RealManRobot/rm_models/RML63/dimension/RML63III_Full_Arm_Dimension_Specification.pdf

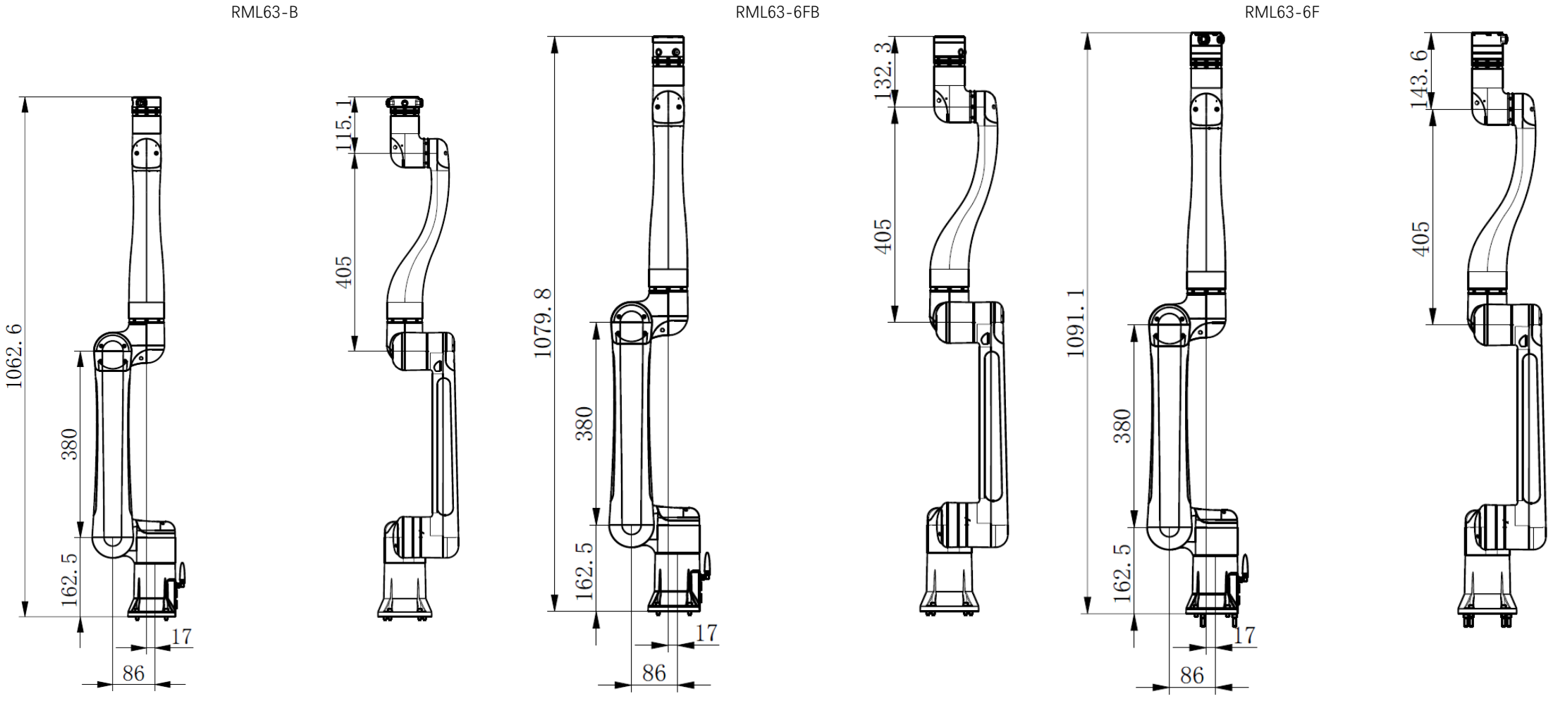
[picture p1: page 1]

RML63-B | RML63-6FB | RML63-6F
