RealManRobot/rm_models/ECO62/urdf/ECO62-B/meshes/link_1.STL

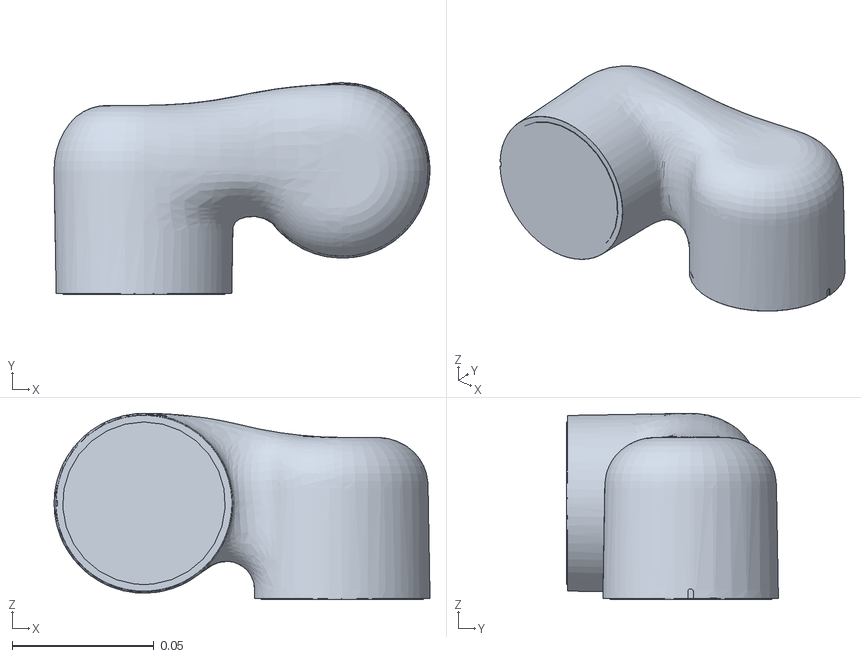
[picture p2: CAD file, 2026-03-18]
ECO62/urdf/ECO62-B/meshes/link_1.STL
0.133 x 0.0748 x 0.0658
