RealManRobot/rm_models/RM65/urdf/RM65-6FB-V/meshes/camera_link.STL

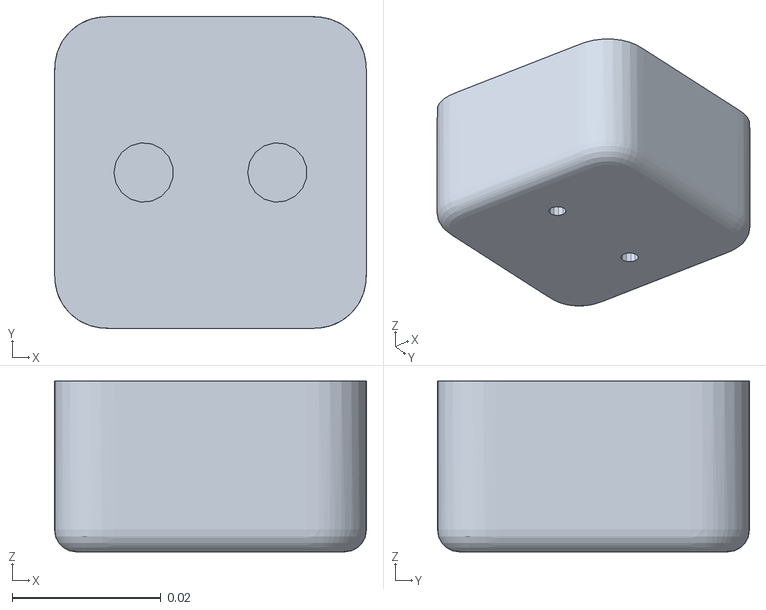
[picture p3: CAD file, 2025-12-05]
RM65/urdf/RM65-6FB-V/meshes/camera_link.STL
0.042 x 0.042 x 0.023
