RealManRobot/rm_models/RM65/urdf/RM65-B-V/meshes/camera_rolink.STL

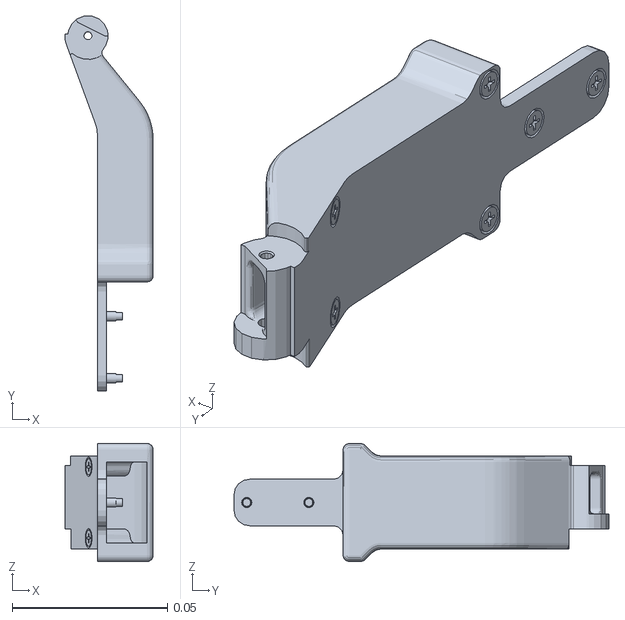
[picture p4: CAD file, 2025-12-05]
RM65/urdf/RM65-B-V/meshes/camera_rolink.STL
0.0285 x 0.121 x 0.038
