RealManRobot/rm_models/RX75/urdf/RX75-B-V/RXL-B-V/meshes/base_link.STL

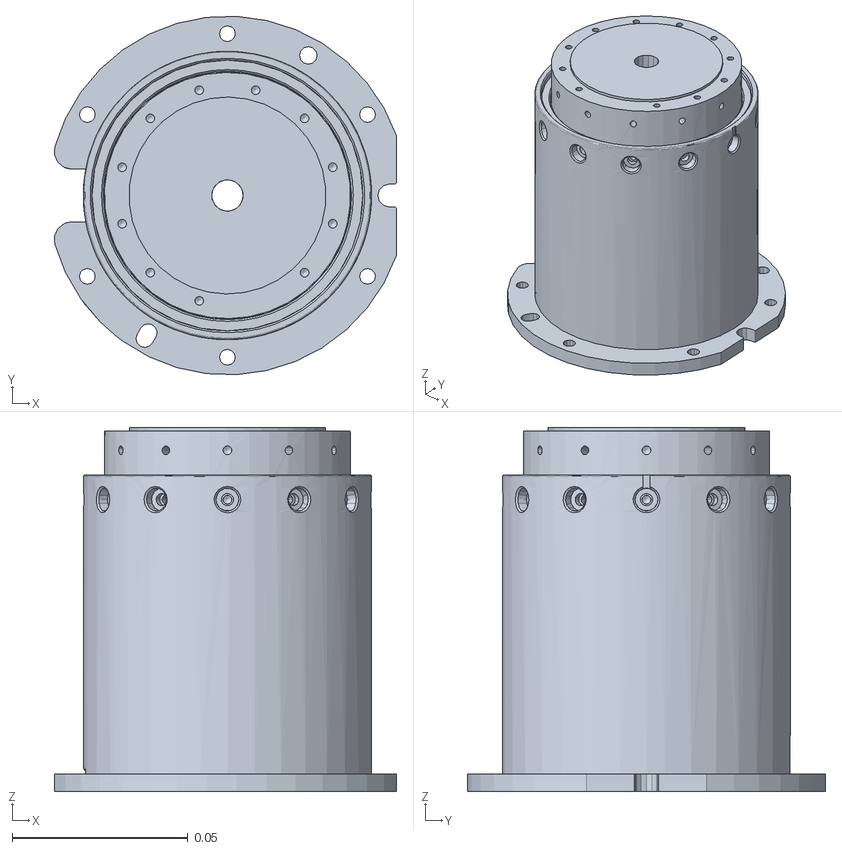
[picture p5: CAD file, 2026-07-03]
RX75/urdf/RX75-B-V/RXL-B-V/meshes/base_link.STL
0.0973 x 0.102 x 0.104
