RealManRobot/rm_models/RX75/urdf/RX75-B-V/RXR-B-V/meshes/Link2.STL

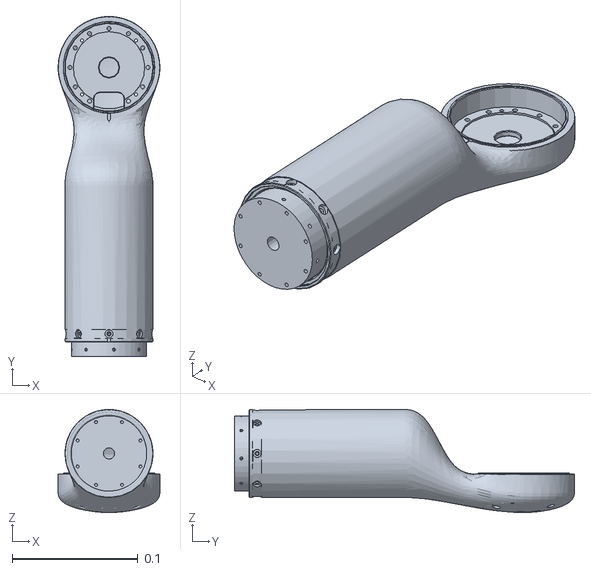
[picture p6: CAD file, 2026-07-03]
RX75/urdf/RX75-B-V/RXR-B-V/meshes/Link2.STL
0.081 x 0.271 x 0.082
