RealManRobot/rm_models/ECO62/urdf/ECO62-B/meshes/link_5.STL

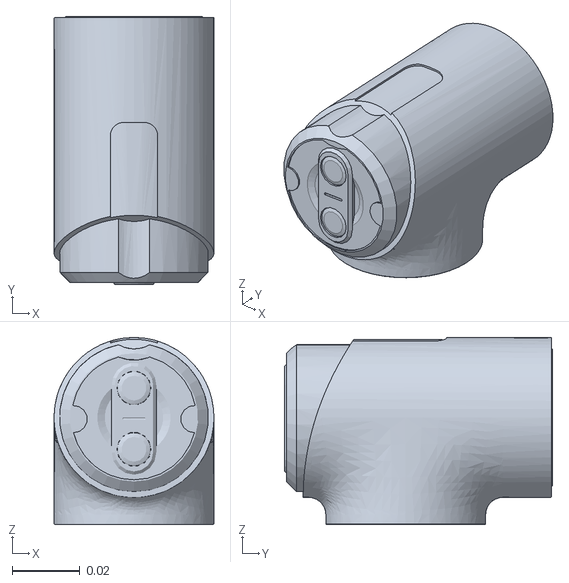
[picture p7: CAD file, 2026-03-18]
ECO62/urdf/ECO62-B/meshes/link_5.STL
0.047 x 0.0789 x 0.055
