RealManRobot/rm_models/GEN72/urdf/gen_72_b_description/meshes/base_link.STL

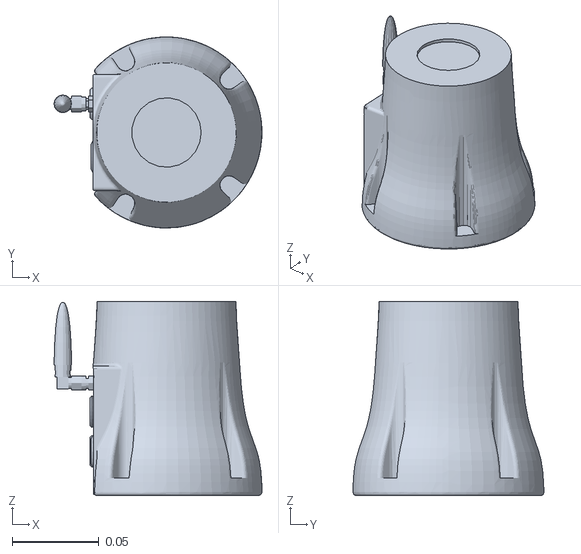
[picture p8: CAD file, 2024-08-14]
GEN72/urdf/gen_72_b_description/meshes/base_link.STL
0.12 x 0.11 x 0.112
