RealManRobot/rm_models/RM75/urdf/RM75-6F/meshes/link_7.STL

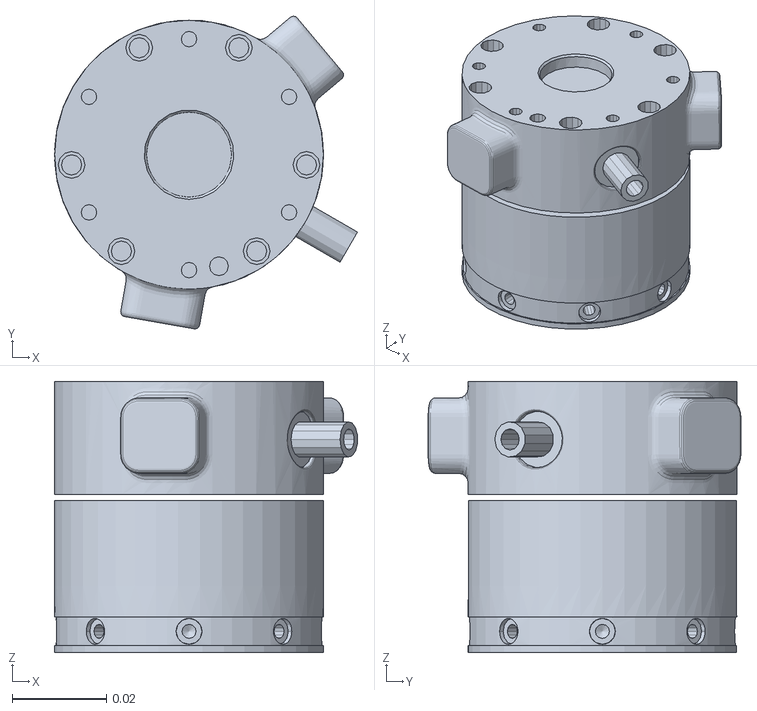
[picture p9: CAD file, 2025-12-05]
RM75/urdf/RM75-6F/meshes/link_7.STL
0.0643 x 0.0663 x 0.0575
