RealManRobot/rm_models/RX75/urdf/RX75-B-V/RXL-B-V/meshes/Link6.STL

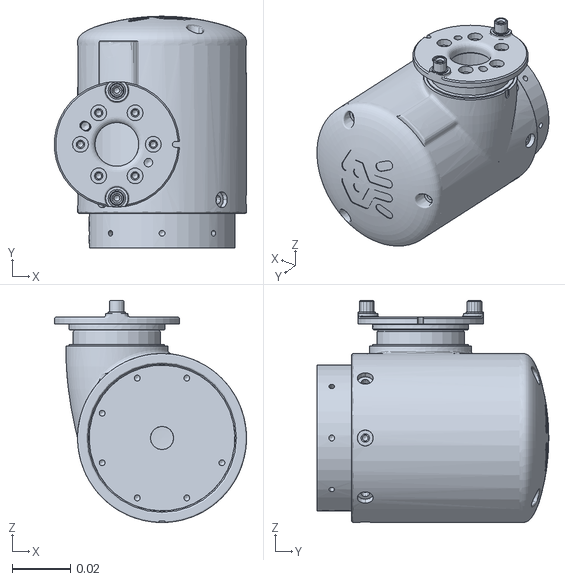
[picture p10: CAD file, 2026-07-03]
RX75/urdf/RX75-B-V/RXL-B-V/meshes/Link6.STL
0.0659 x 0.0795 x 0.0762
