RealManRobot/rm_models/RX75/urdf/RX75-B-V/RXR-B-V/meshes/Link8.STL

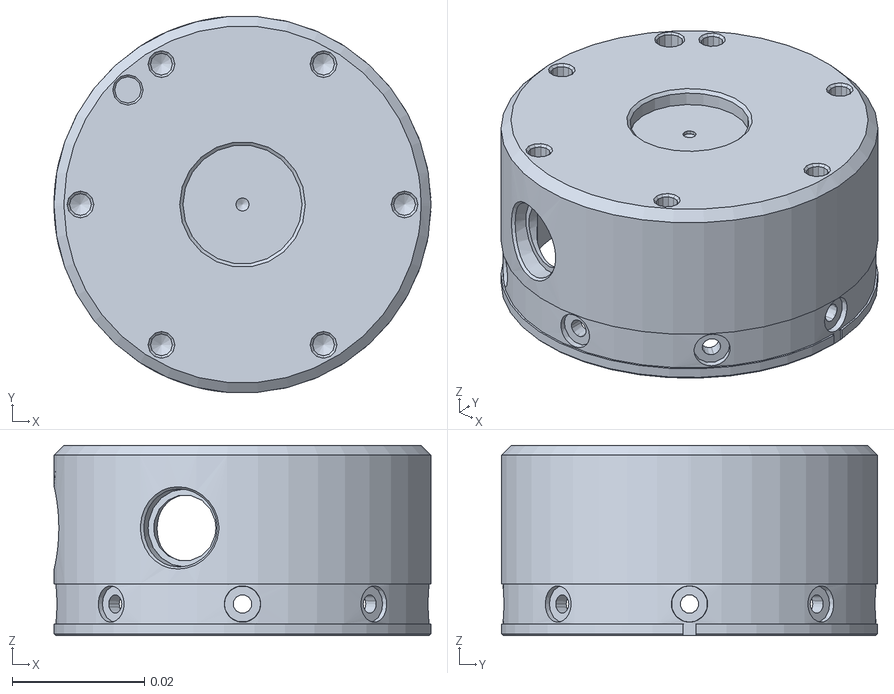
[picture p11: CAD file, 2026-07-03]
RX75/urdf/RX75-B-V/RXR-B-V/meshes/Link8.STL
0.057 x 0.0569 x 0.0288
