RealManRobot/rm_models/ECO62/urdf/ECO62-B/meshes/link_6.STL

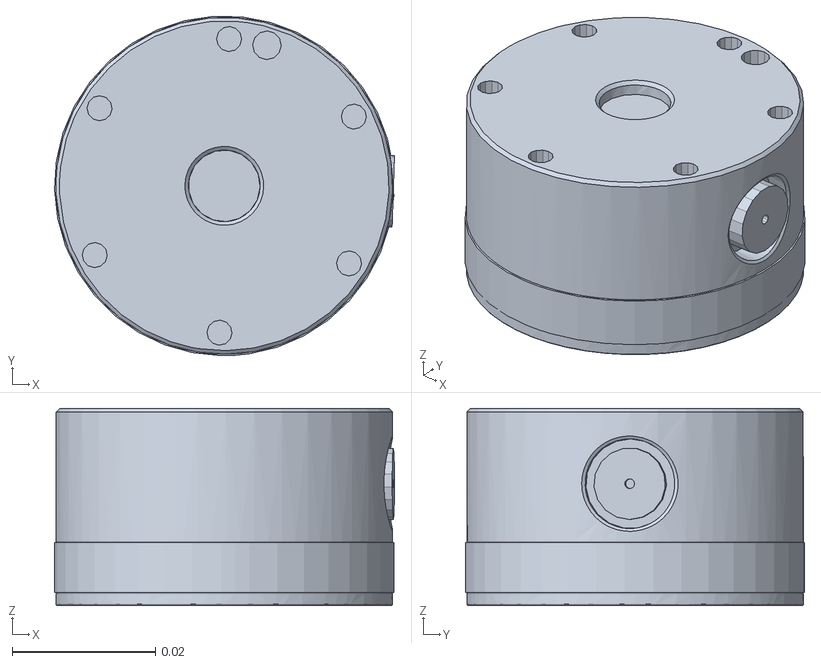
[picture p12: CAD file, 2026-03-18]
ECO62/urdf/ECO62-B/meshes/link_6.STL
0.0474 x 0.0473 x 0.0275
