RealManRobot/rm_models/RM75/urdf/RM75-6FB-V/meshes/link_7.STL

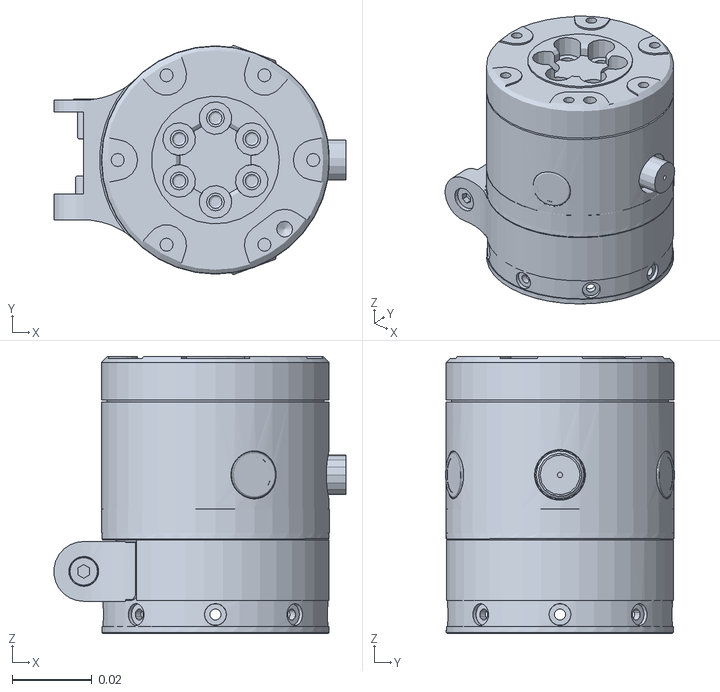
[picture p13: CAD file, 2025-12-05]
RM75/urdf/RM75-6FB-V/meshes/link_7.STL
0.0731 x 0.0574 x 0.0695
