RealManRobot/rm_models/RM75/urdf/RM75-B-V/meshes/link_7.STL

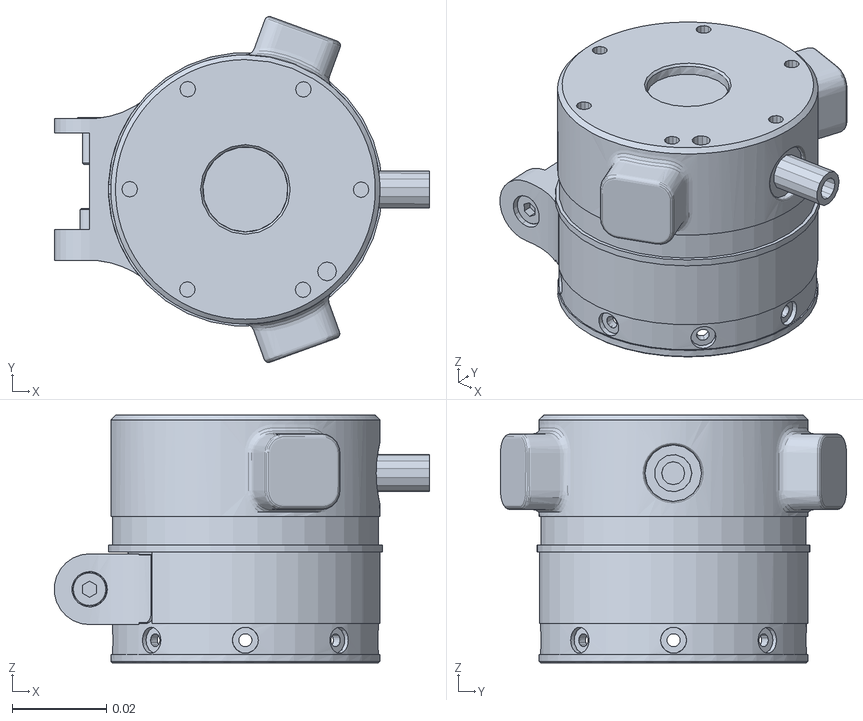
[picture p14: CAD file, 2025-12-05]
RM75/urdf/RM75-B-V/meshes/link_7.STL
0.0795 x 0.0733 x 0.0525
