RealManRobot/rm_models/RML63/urdf/RML63II/RML63II-6FB-V/meshes/camera_link.STL

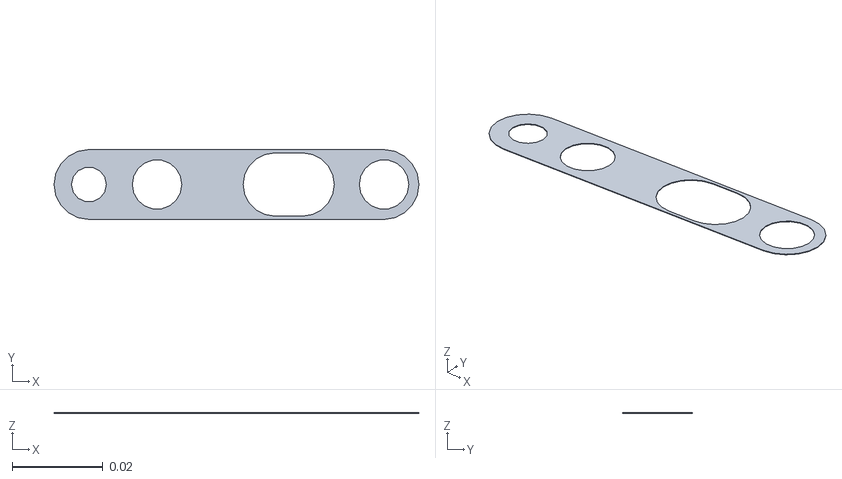
[picture p15: CAD file, 2025-12-05]
RML63/urdf/RML63II/RML63II-6FB-V/meshes/camera_link.STL
0.0804 x 0.0154 x 0.00013
