RealManRobot/rm_models/RX75/urdf/RX75-B-V/RXR-B-V/meshes/Link4.STL

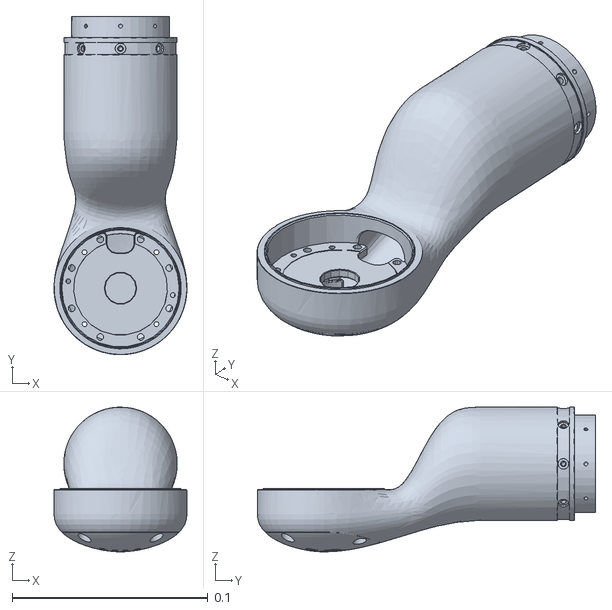
[picture p16: CAD file, 2026-07-03]
RX75/urdf/RX75-B-V/RXR-B-V/meshes/Link4.STL
0.068 x 0.173 x 0.074
