RealManRobot/rm_models/ECO62/urdf/ECO62-B/meshes/base_link.STL

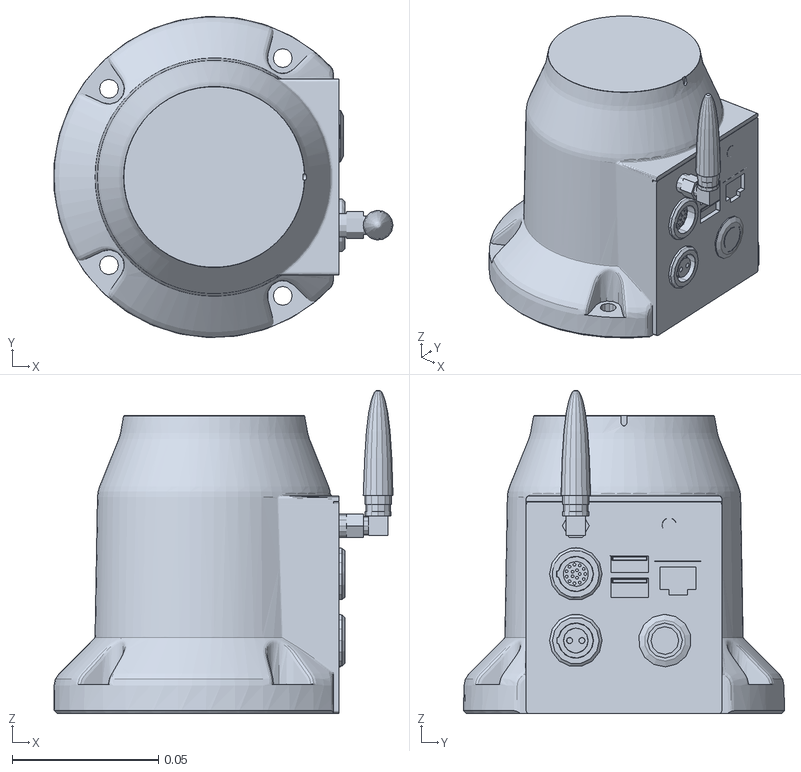
[picture p17: CAD file, 2026-03-18]
ECO62/urdf/ECO62-B/meshes/base_link.STL
0.116 x 0.11 x 0.111
