RealManRobot/rm_models/RX75/urdf/RX75-B-V/RXR-B-V/meshes/Link5.STL

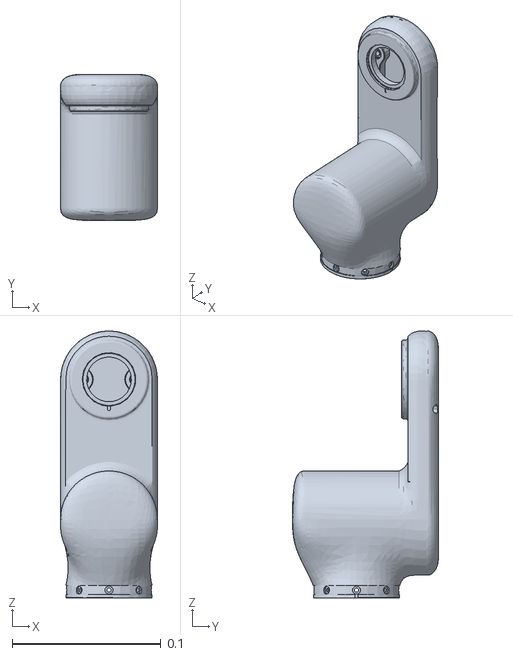
[picture p18: CAD file, 2026-07-03]
RX75/urdf/RX75-B-V/RXR-B-V/meshes/Link5.STL
0.065 x 0.0981 x 0.179
