RealManRobot/rm_models/ECO62/urdf/ECO62-B/meshes/link_3.STL

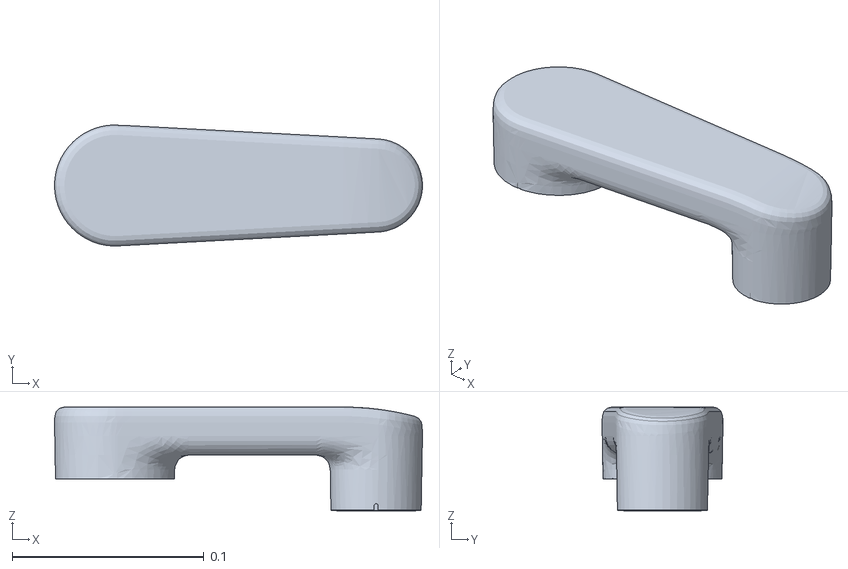
[picture p19: CAD file, 2026-03-18]
ECO62/urdf/ECO62-B/meshes/link_3.STL
0.192 x 0.063 x 0.0541
