RealManRobot/rm_models/RX75/urdf/RX75-B-V/RXR-B-V/meshes/Link3.STL

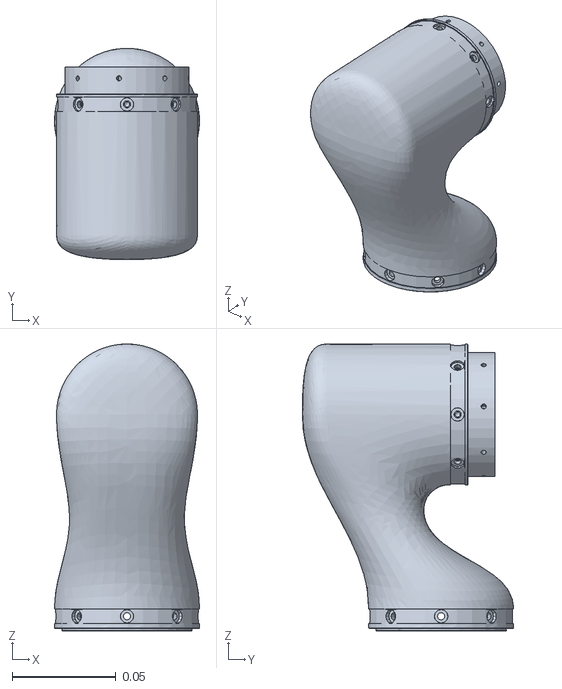
[picture p20: CAD file, 2026-03-25]
RX75/urdf/RX75-B-V/RXR-B-V/meshes/Link3.STL
0.07 x 0.102 x 0.138
