RealManRobot/rm_models/ECO62/urdf/ECO62-B/meshes/link_4.STL

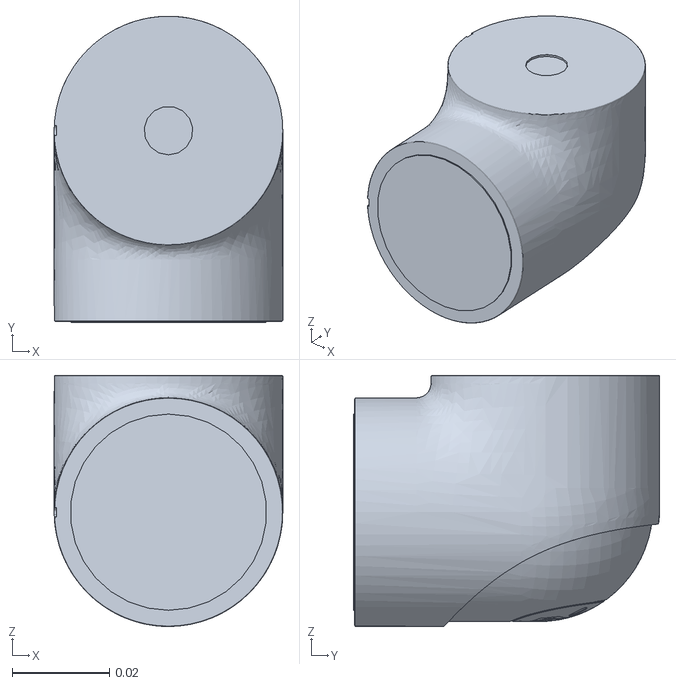
[picture p21: CAD file, 2026-03-18]
ECO62/urdf/ECO62-B/meshes/link_4.STL
0.047 x 0.063 x 0.0516
