RealManRobot/rm_models/RX75/urdf/RX75-B-V/RXL-B-V/meshes/Link7.STL

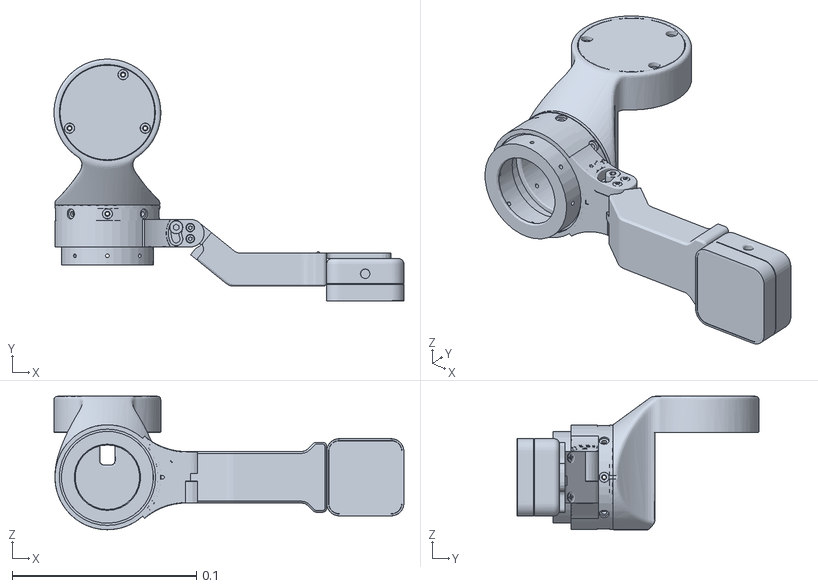
[picture p22: CAD file, 2026-07-03]
RX75/urdf/RX75-B-V/RXL-B-V/meshes/Link7.STL
0.19 x 0.131 x 0.0725
