RealManRobot/rm_models/RX75/urdf/RX75-B-V/RXR-B-V/meshes/Link7.STL

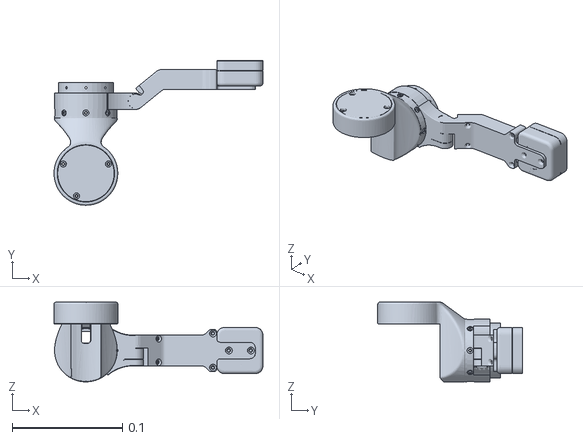
[picture p23: CAD file, 2026-03-25]
RX75/urdf/RX75-B-V/RXR-B-V/meshes/Link7.STL
0.19 x 0.131 x 0.0725
