RealManRobot/rm_models/ECO62/urdf/ECO62-B/meshes/link_2.STL

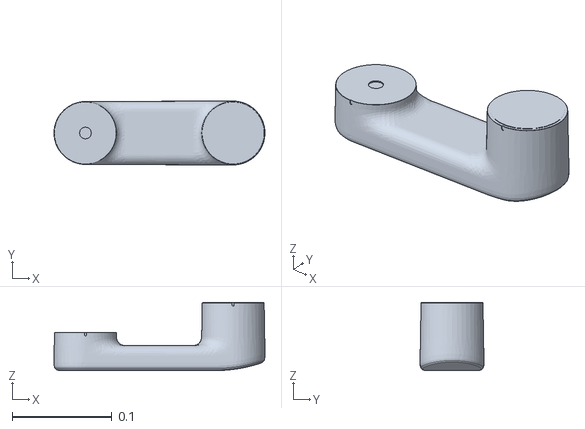
[picture p24: CAD file, 2026-03-18]
ECO62/urdf/ECO62-B/meshes/link_2.STL
0.211 x 0.064 x 0.0683
