RealManRobot/rm_models/RM75/urdf/RM75-6FB/meshes/link_7.STL

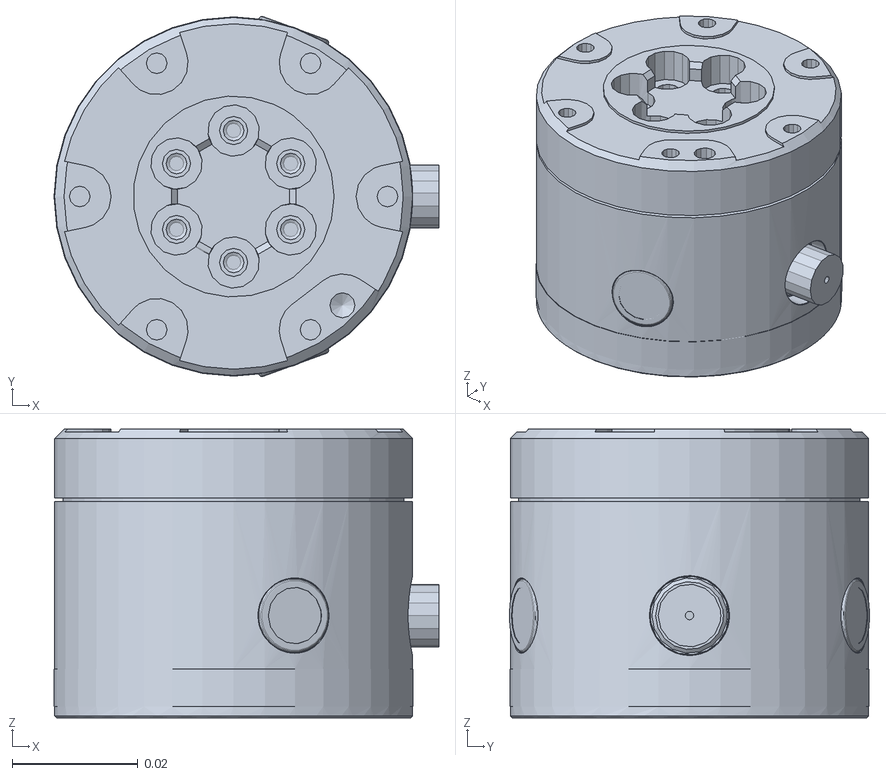
[picture p25: CAD file, 2025-12-05]
RM75/urdf/RM75-6FB/meshes/link_7.STL
0.0613 x 0.0574 x 0.046
