RealManRobot/rm_models/RX75/urdf/RX75-B-V/RXL-B-V/meshes/Link1.STL

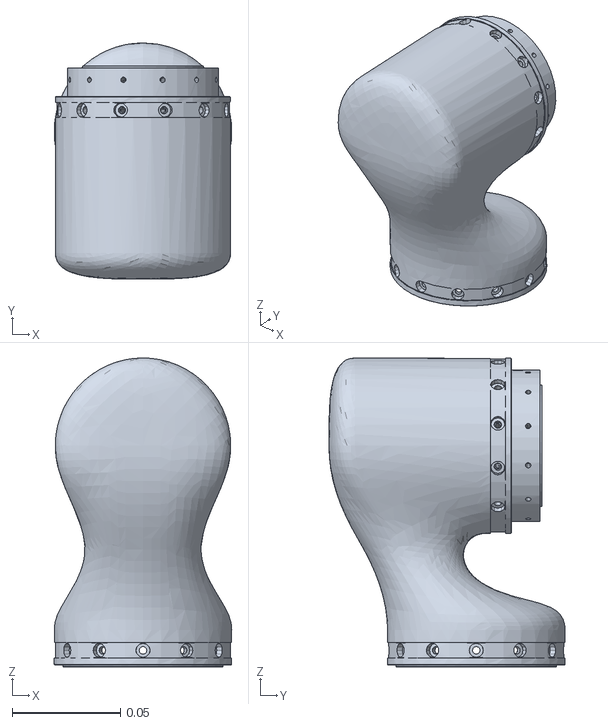
[picture p27: CAD file, 2026-03-25]
RX75/urdf/RX75-B-V/RXL-B-V/meshes/Link1.STL
0.082 x 0.109 x 0.143
