RealManRobot/rm_models/(list of files, cad)

Other CAD files:
RML63/urdf/RML63III/RML63III-6FB-V/meshes/camera_rolink.STL
RML63/urdf/RML63III/RML63III-B-V/meshes/camera_link.STL
RML63/urdf/RML63III/RML63III-6FB-V/meshes/camera_link.STL
RX75/urdf/RX75-B-V/RXL-B-V/meshes/Link2.STL
RX75/urdf/RX75-B-V/RXL-B-V/meshes/Link8.STL
RX75/urdf/RX75-6FB-V/RXL-6FB-V/meshes/base_link.STL
RX75/urdf/RX75-6FB/RXL-6F-C3/meshes/Link2L.STL
RX75/urdf/RX75-B-V/RXL-B-V/meshes/Link5.STL
RX75/urdf/RX75-6FB/RXL-6F-C3/meshes/base_link.STL
RX75/urdf/RX75-B-V/RXL-B-V/meshes/Link4.STL
RX75/urdf/RX75-B-V/RXR-B-V/meshes/Link6.STL
RML63/urdf/RML63III/RML63III-B-V/meshes/camera_rolink.STL
RX75/urdf/RX75-B-V/RXR-B-V/meshes/Link1.STL
RX75/urdf/RX75-B-V/RXL-B-V/meshes/Link3.STL
RX75/urdf/RX75-B-V/RXR-B-V/meshes/base_link.STL
ECO63/urdf/ECO63-6F/meshes/base_link.STL
ECO63/urdf/ECO63-6F/meshes/link_1.STL
ECO63/urdf/ECO63-6F/meshes/link_2.STL
ECO63/urdf/ECO63-6F/meshes/link_3.STL
ECO63/urdf/ECO63-6F/meshes/link_4.STL
ECO63/urdf/ECO63-6F/meshes/link_5.STL
ECO63/urdf/ECO63-6F/meshes/link_6.STL
ECO63/urdf/ECO63-6FB/meshes/base_link.STL
ECO63/urdf/ECO63-6FB/meshes/link_1.STL
ECO63/urdf/ECO63-6FB/meshes/link_2.STL
ECO63/urdf/ECO63-6FB/meshes/link_3.STL
ECO63/urdf/ECO63-6FB/meshes/link_4.STL
ECO63/urdf/ECO63-6FB/meshes/link_5.STL
ECO63/urdf/ECO63-6FB/meshes/link_6.STL
ECO63/urdf/ECO63-B/meshes/base_link.STL
ECO63/urdf/ECO63-B/meshes/link_1.STL
ECO63/urdf/ECO63-B/meshes/link_2.STL
ECO63/urdf/ECO63-B/meshes/link_3.STL
ECO63/urdf/ECO63-B/meshes/link_4.STL
ECO63/urdf/ECO63-B/meshes/link_5.STL
ECO63/urdf/ECO63-B/meshes/link_6.STL
ECO65/urdf/ECO65-6F/meshes/base_link.STL
ECO65/urdf/ECO65-6F/meshes/link_1.STL
ECO65/urdf/ECO65-6F/meshes/link_2.STL
ECO65/urdf/ECO65-6F/meshes/link_3.STL
ECO65/urdf/ECO65-6F/meshes/link_4.STL
ECO65/urdf/ECO65-6F/meshes/link_5.STL
ECO65/urdf/ECO65-6F/meshes/link_6.STL
ECO65/urdf/ECO65-6FB/meshes/base_link.STL
ECO65/urdf/ECO65-6FB/meshes/link_1.STL
ECO65/urdf/ECO65-6FB/meshes/link_2.STL
ECO65/urdf/ECO65-6FB/meshes/link_3.STL
ECO65/urdf/ECO65-6FB/meshes/link_4.STL
ECO65/urdf/ECO65-6FB/meshes/link_5.STL
ECO65/urdf/ECO65-6FB/meshes/link_6.STL
ECO65/urdf/ECO65-B/meshes/base_link.STL
ECO65/urdf/ECO65-B/meshes/link_1.STL
ECO65/urdf/ECO65-B/meshes/link_2.STL
ECO65/urdf/ECO65-B/meshes/link_3.STL
ECO65/urdf/ECO65-B/meshes/link_4.STL
ECO65/urdf/ECO65-B/meshes/link_5.STL
ECO65/urdf/ECO65-B/meshes/link_6.STL
GEN72/urdf/gen_72_b_description/meshes/Link1.STL
GEN72/urdf/gen_72_b_description/meshes/Link2.STL
GEN72/urdf/gen_72_b_description/meshes/Link3.STL
GEN72/urdf/gen_72_b_description/meshes/Link4.STL
GEN72/urdf/gen_72_b_description/meshes/Link5.STL
GEN72/urdf/gen_72_b_description/meshes/Link6.STL
GEN72/urdf/gen_72_b_description/meshes/Link7.STL
RM65/urdf/RM65-6F/meshes/base_link.STL
RM65/urdf/RM65-6F/meshes/link_1.STL
RM65/urdf/RM65-6F/meshes/link_2.STL
RM65/urdf/RM65-6F/meshes/link_3.STL
RM65/urdf/RM65-6F/meshes/link_4.STL
RM65/urdf/RM65-6F/meshes/link_5.STL
RM65/urdf/RM65-6FB-V/meshes/base_link.STL
RM65/urdf/RM65-6FB-V/meshes/link_1.STL
RM65/urdf/RM65-6FB-V/meshes/link_2.STL
RM65/urdf/RM65-6FB-V/meshes/link_3.STL
RM65/urdf/RM65-6FB-V/meshes/link_4.STL
RM65/urdf/RM65-6FB-V/meshes/link_5.STL
RM65/urdf/RM65-6FB-V/meshes/link_6.STL
RM65/urdf/RM65-6FB/meshes/base_link.STL
RM65/urdf/RM65-6FB/meshes/link_1.STL
RM65/urdf/RM65-6FB/meshes/link_2.STL
RM65/urdf/RM65-6FB/meshes/link_3.STL
RM65/urdf/RM65-6FB/meshes/link_4.STL
RM65/urdf/RM65-6FB/meshes/link_5.STL
RM65/urdf/RM65-6FB/meshes/link_6.STL
RM65/urdf/RM65-B-V/meshes/base_link.STL
RM65/urdf/RM65-B-V/meshes/link_1.STL
RM65/urdf/RM65-B-V/meshes/link_2.STL
RM65/urdf/RM65-B-V/meshes/link_3.STL
RM65/urdf/RM65-B-V/meshes/link_4.STL
RM65/urdf/RM65-B-V/meshes/link_5.STL
RM65/urdf/RM65-B/meshes/base_link.STL
RM65/urdf/RM65-B/meshes/link_1.STL
RM65/urdf/RM65-B/meshes/link_2.STL
RM65/urdf/RM65-B/meshes/link_3.STL
RM65/urdf/RM65-B/meshes/link_4.STL
RM65/urdf/RM65-B/meshes/link_5.STL
RM75/urdf/RM75-6F/meshes/base_link.STL
RM75/urdf/RM75-6F/meshes/link_1.STL
RM75/urdf/RM75-6F/meshes/link_2.STL
RM75/urdf/RM75-6F/meshes/link_3.STL
RM75/urdf/RM75-6F/meshes/link_4.STL
RM75/urdf/RM75-6F/meshes/link_5.STL
RM75/urdf/RM75-6F/meshes/link_6.STL
RM75/urdf/RM75-6FB-V/meshes/base_link.STL
RM75/urdf/RM75-6FB-V/meshes/link_1.STL
RM75/urdf/RM75-6FB-V/meshes/link_2.STL
RM75/urdf/RM75-6FB-V/meshes/link_3.STL
RM75/urdf/RM75-6FB-V/meshes/link_4.STL
RM75/urdf/RM75-6FB-V/meshes/link_5.STL
RM75/urdf/RM75-6FB-V/meshes/link_6.STL
RM75/urdf/RM75-6FB/meshes/base_link.STL
RM75/urdf/RM75-6FB/meshes/link_1.STL
RM75/urdf/RM75-6FB/meshes/link_2.STL
RM75/urdf/RM75-6FB/meshes/link_3.STL
RM75/urdf/RM75-6FB/meshes/link_4.STL
RM75/urdf/RM75-6FB/meshes/link_5.STL
RM75/urdf/RM75-6FB/meshes/link_6.STL
RM75/urdf/RM75-B-V/meshes/base_link.STL
RM75/urdf/RM75-B-V/meshes/link_1.STL
RM75/urdf/RM75-B-V/meshes/link_2.STL
RM75/urdf/RM75-B-V/meshes/link_3.STL
RM75/urdf/RM75-B-V/meshes/link_4.STL
RM75/urdf/RM75-B-V/meshes/link_5.STL
RM75/urdf/RM75-B-V/meshes/link_6.STL
RM75/urdf/RM75-B/meshes/base_link.STL
RM75/urdf/RM75-B/meshes/link_1.STL
RM75/urdf/RM75-B/meshes/link_2.STL
RM75/urdf/RM75-B/meshes/link_3.STL
RM75/urdf/RM75-B/meshes/link_4.STL
RM75/urdf/RM75-B/meshes/link_5.STL
RM75/urdf/RM75-B/meshes/link_6.STL
RML63/urdf/RML63II/RML63II-6F-V/meshes/base_link.STL
RML63/urdf/RML63II/RML63II-6F-V/meshes/link_1.STL
RML63/urdf/RML63II/RML63II-6F-V/meshes/link_2.STL
RML63/urdf/RML63II/RML63II-6F-V/meshes/link_3.STL
RML63/urdf/RML63II/RML63II-6F-V/meshes/link_4.STL
RML63/urdf/RML63II/RML63II-6F-V/meshes/link_5.STL
RML63/urdf/RML63II/RML63II-6F-V/meshes/link_6.STL
RML63/urdf/RML63II/RML63II-6F/meshes/base_link.STL
RML63/urdf/RML63II/RML63II-6F/meshes/link_1.STL
RML63/urdf/RML63II/RML63II-6F/meshes/link_2.STL
RML63/urdf/RML63II/RML63II-6F/meshes/link_3.STL
RML63/urdf/RML63II/RML63II-6F/meshes/link_4.STL
RML63/urdf/RML63II/RML63II-6F/meshes/link_5.STL
RML63/urdf/RML63II/RML63II-6F/meshes/link_6.STL
RML63/urdf/RML63II/RML63II-6FB-V/meshes/base_link.STL
RML63/urdf/RML63II/RML63II-6FB-V/meshes/link_1.STL
RML63/urdf/RML63II/RML63II-6FB-V/meshes/link_2.STL
RML63/urdf/RML63II/RML63II-6FB-V/meshes/link_3.STL
RML63/urdf/RML63II/RML63II-6FB-V/meshes/link_4.STL
RML63/urdf/RML63II/RML63II-6FB-V/meshes/link_5.STL
RML63/urdf/RML63II/RML63II-6FB-V/meshes/link_6.STL
RML63/urdf/RML63II/RML63II-6FB/meshes/base_link.STL
RML63/urdf/RML63II/RML63II-6FB/meshes/link_1.STL
RML63/urdf/RML63II/RML63II-6FB/meshes/link_2.STL
RML63/urdf/RML63II/RML63II-6FB/meshes/link_3.STL
RML63/urdf/RML63II/RML63II-6FB/meshes/link_4.STL
RML63/urdf/RML63II/RML63II-6FB/meshes/link_5.STL
RML63/urdf/RML63II/RML63II-6FB/meshes/link_6.STL
RML63/urdf/RML63II/RML63II-B-V/meshes/base_link.STL
RML63/urdf/RML63II/RML63II-B-V/meshes/link_1.STL
RML63/urdf/RML63II/RML63II-B-V/meshes/link_2.STL
RML63/urdf/RML63II/RML63II-B-V/meshes/link_3.STL
RML63/urdf/RML63II/RML63II-B-V/meshes/link_4.STL
RML63/urdf/RML63II/RML63II-B-V/meshes/link_5.STL
RML63/urdf/RML63II/RML63II-B-V/meshes/link_6.STL
RML63/urdf/RML63II/RML63II-B/meshes/base_link.STL
RML63/urdf/RML63II/RML63II-B/meshes/link_1.STL
RML63/urdf/RML63II/RML63II-B/meshes/link_2.STL
RML63/urdf/RML63II/RML63II-B/meshes/link_3.STL
RML63/urdf/RML63II/RML63II-B/meshes/link_4.STL
RML63/urdf/RML63II/RML63II-B/meshes/link_5.STL
RML63/urdf/RML63II/RML63II-B/meshes/link_6.STL
RML63/urdf/RML63III/RML63III-6F/meshes/base_link.STL
RML63/urdf/RML63III/RML63III-6F/meshes/link_1.STL
RML63/urdf/RML63III/RML63III-6F/meshes/link_2.STL
RML63/urdf/RML63III/RML63III-6F/meshes/link_3.STL
RML63/urdf/RML63III/RML63III-6F/meshes/link_4.STL
RML63/urdf/RML63III/RML63III-6F/meshes/link_5.STL
RML63/urdf/RML63III/RML63III-6F/meshes/link_6.STL
RML63/urdf/RML63III/RML63III-6FB-V/meshes/base_link.STL
RML63/urdf/RML63III/RML63III-6FB-V/meshes/link_1.STL
RML63/urdf/RML63III/RML63III-6FB-V/meshes/link_2.STL
RML63/urdf/RML63III/RML63III-6FB-V/meshes/link_3.STL
RML63/urdf/RML63III/RML63III-6FB-V/meshes/link_4.STL
RML63/urdf/RML63III/RML63III-6FB-V/meshes/link_5.STL
RML63/urdf/RML63III/RML63III-6FB-V/meshes/link_6.STL
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
