RealManRobot/rm_models/ECO62/dimension/ECO62_Full_Arm_Dimension_Specification.pdf

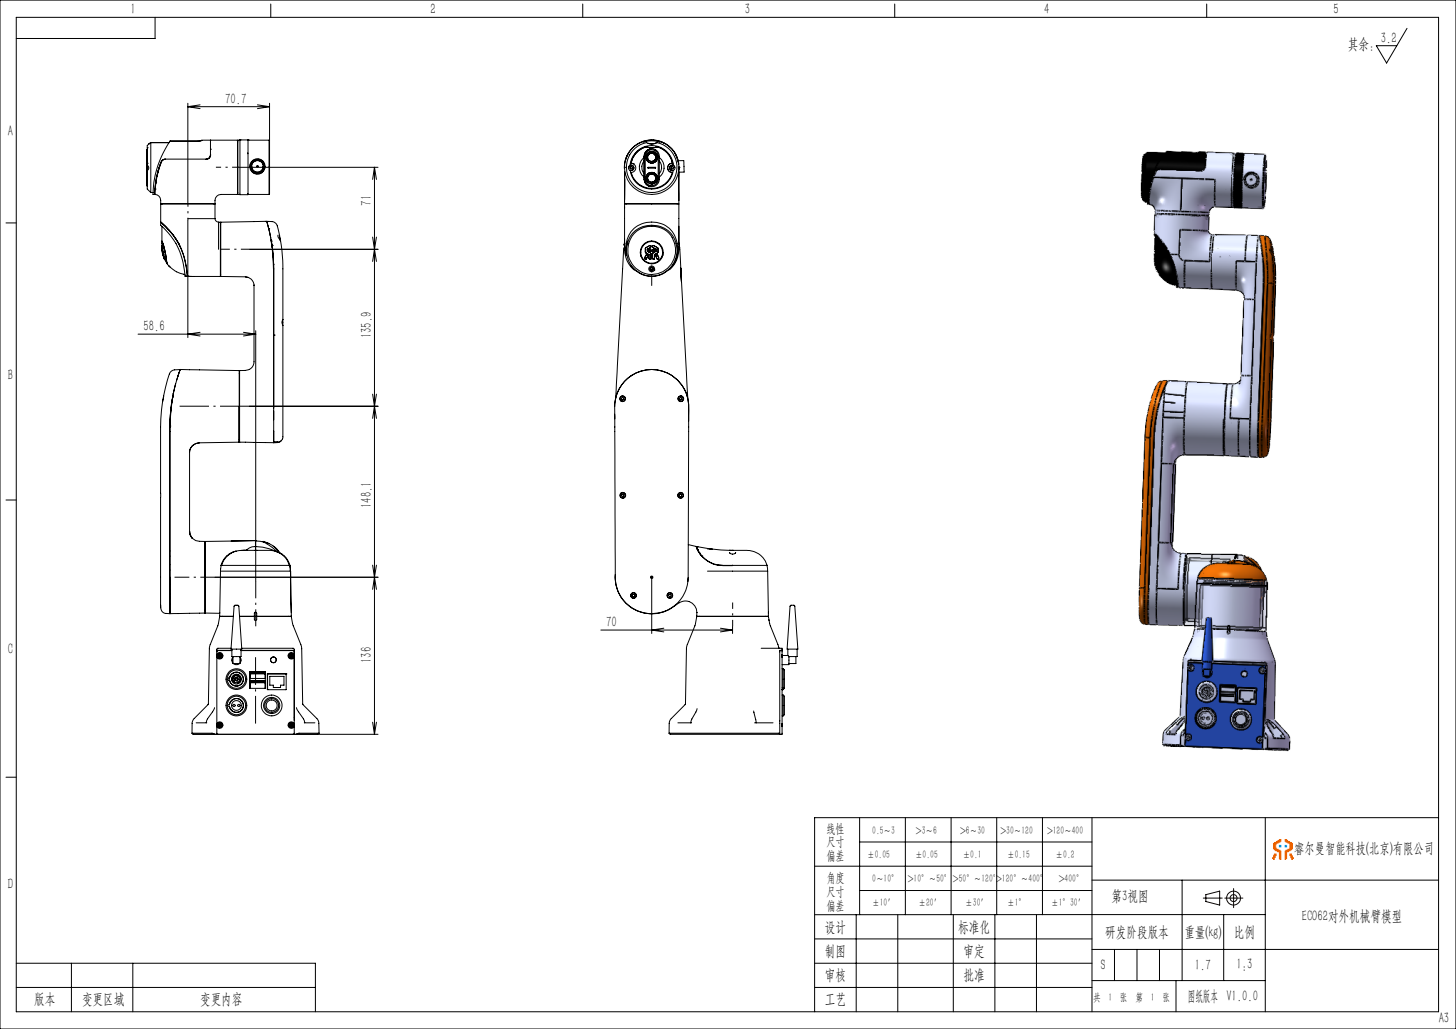
[picture p29: page 1]
变更区域; 变更内容; 图纸版本 V1.0.0

线性 尺寸 偏差 | 0.5～3 | >3～6 | >6～30 | >30～120 | >120～400 | | 睿尔曼智能科技(北京)有限公司

标准化 | | | 研发阶段版本 | 重量(kg) | 比例 | ECO62对外机械臂模型 设计

制图 | | | 审定
审核 | | | 批准
