RealManRobot/rm_models/ECO63/dimension/ECO63_Full_Arm_Dimension_Specification.pdf

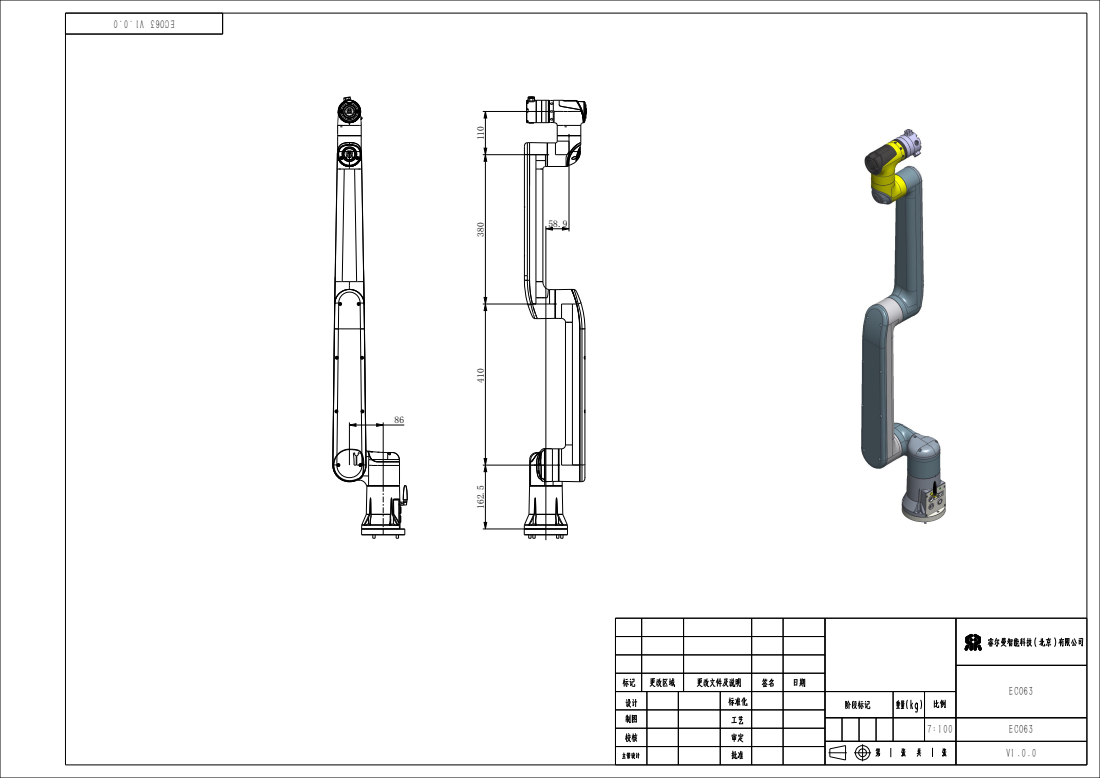
[picture p30: page 1]
阶段标记; ECO63

睿尔曼智能科技(北京)有限公司

标记 | 更改区域 | | | 更改文件及说明 | 签名 | 日期
设计 | | 标准化
制图 | | | 工艺

7:100 | ECO63

主管设计 | | 批准
