RealManRobot/rm_models/ECO65/dimension/ECO65_Full_Arm_Dimension_Specification.pdf

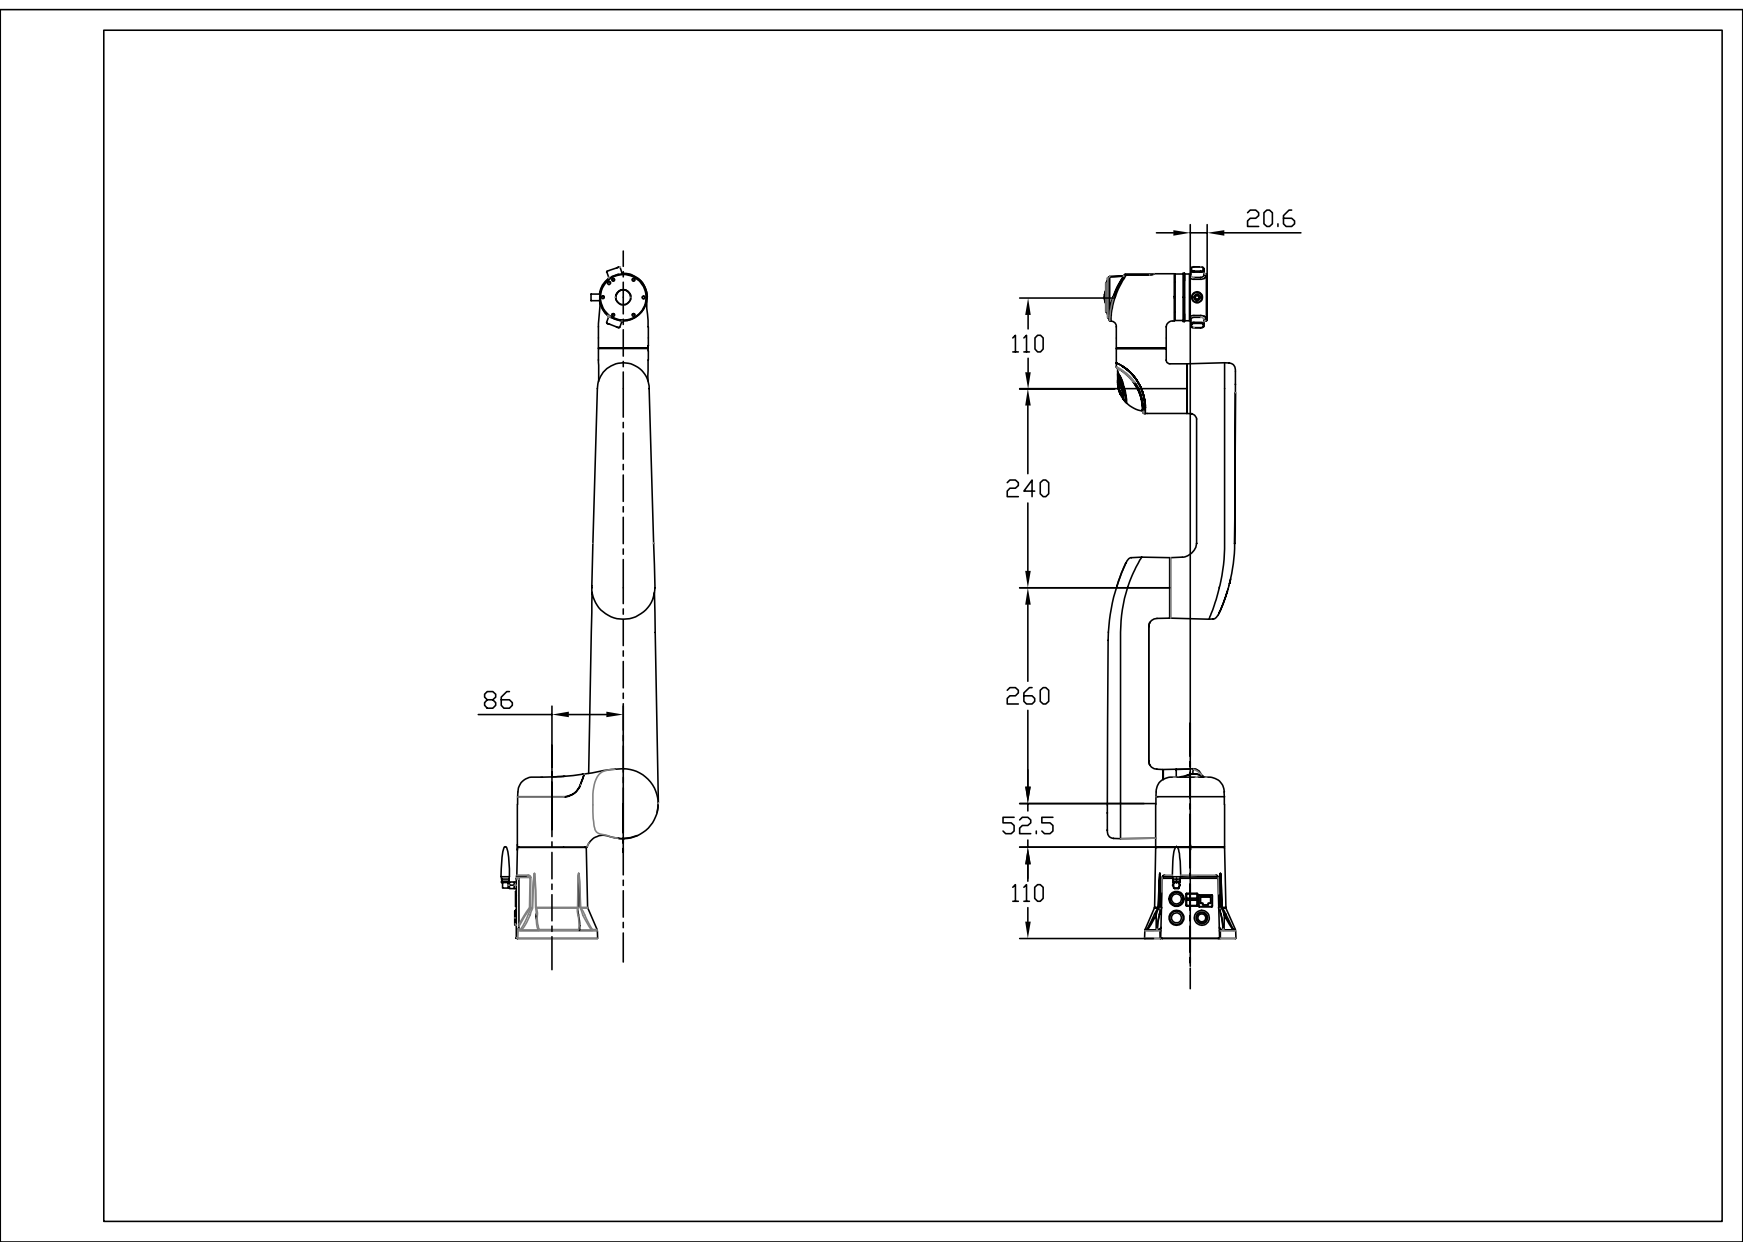
[picture p31: page 1]
