RealManRobot/rm_models/GEN72/dimension/GEN72_Full_Arm_Dimension_Specification.pdf

40 170

95 110 152.50

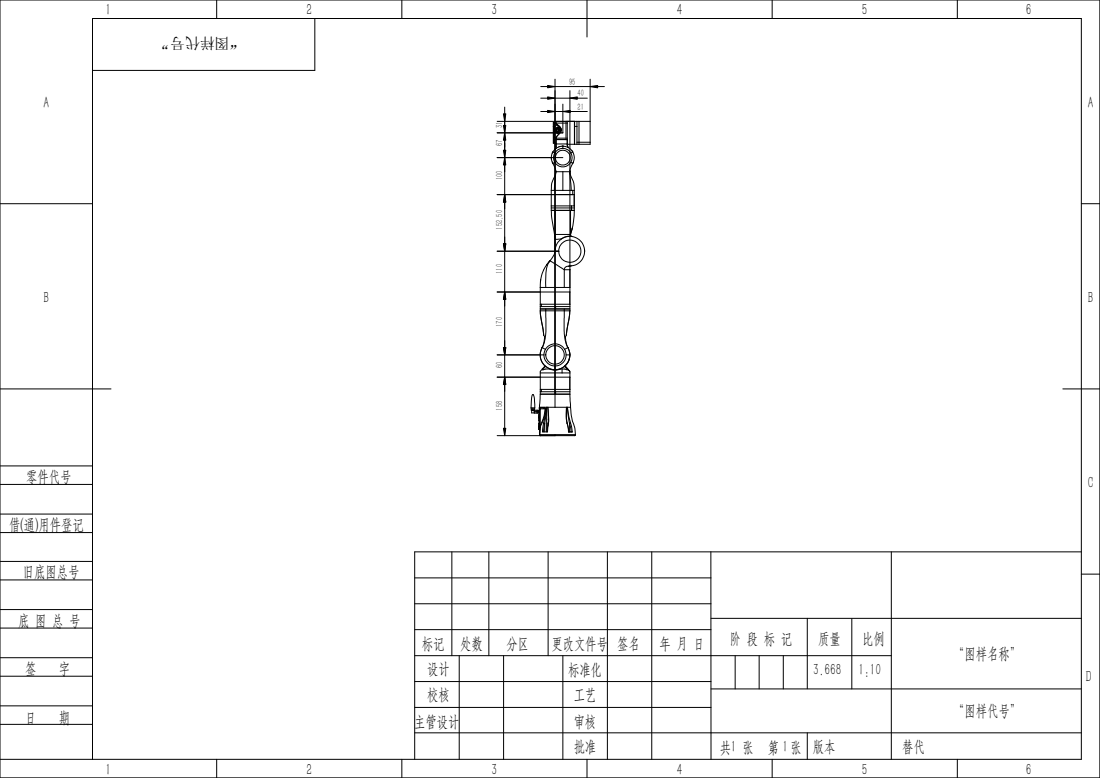
[picture p32: page 1]
标准化; 主管设计; 零件代号; 借(通)用件登记; 旧底图总号

阶 段 标 记 | 质量 | 比例 | “图样名称”

标记 | 处数 | 分区 | 更改文件号 | 签名 | 年 月 日

“图样代号”
