RealManRobot/rm_models/RM65/dimension/RM65_Full_Arm_Dimension_Specification.pdf

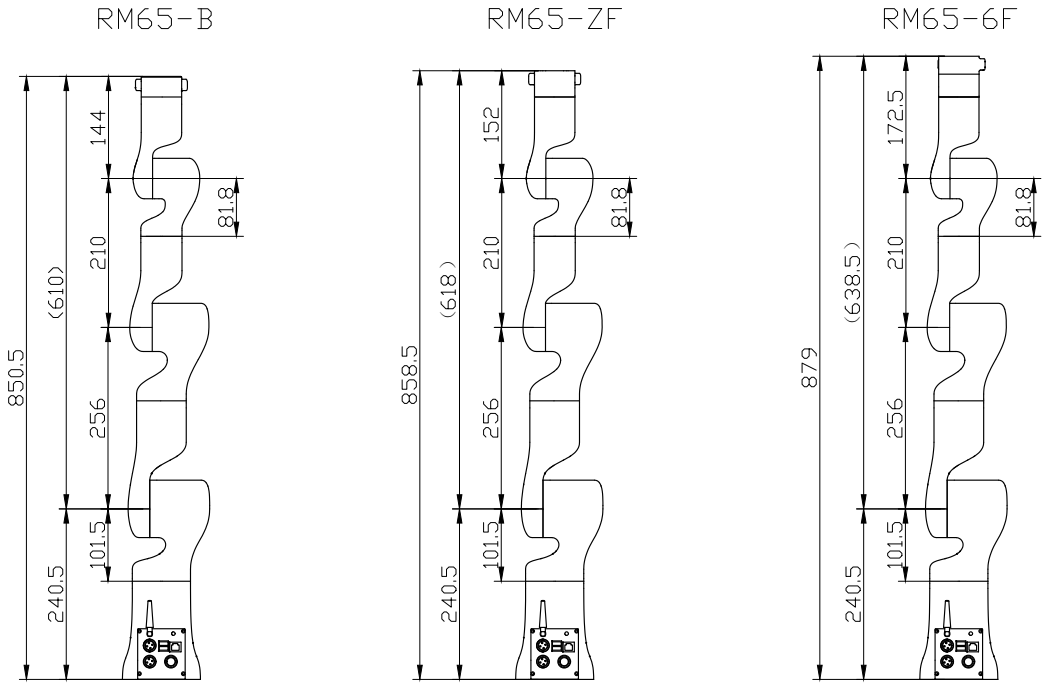
[picture p33: page 1]
