RealManRobot/rm_models/RM75/dimension/RM75_Full_Arm_Dimension_Specification.pdf

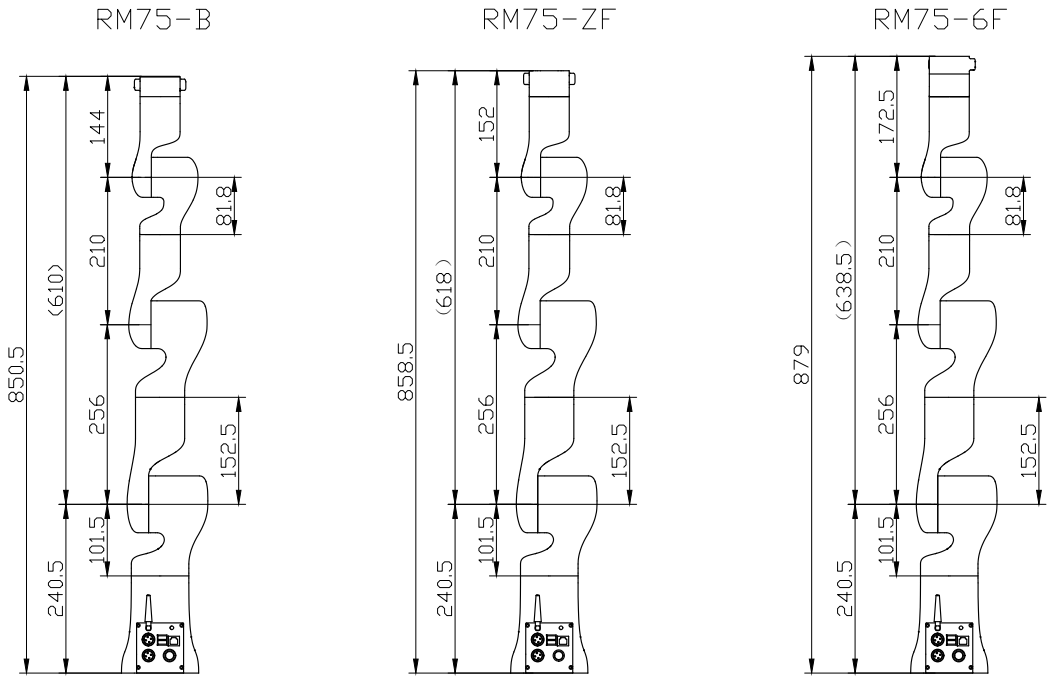
[picture p34: page 1]
