RealManRobot/rm_models/RML63/dimension/RML63II_Full_Arm_Dimension_Specification.pdf

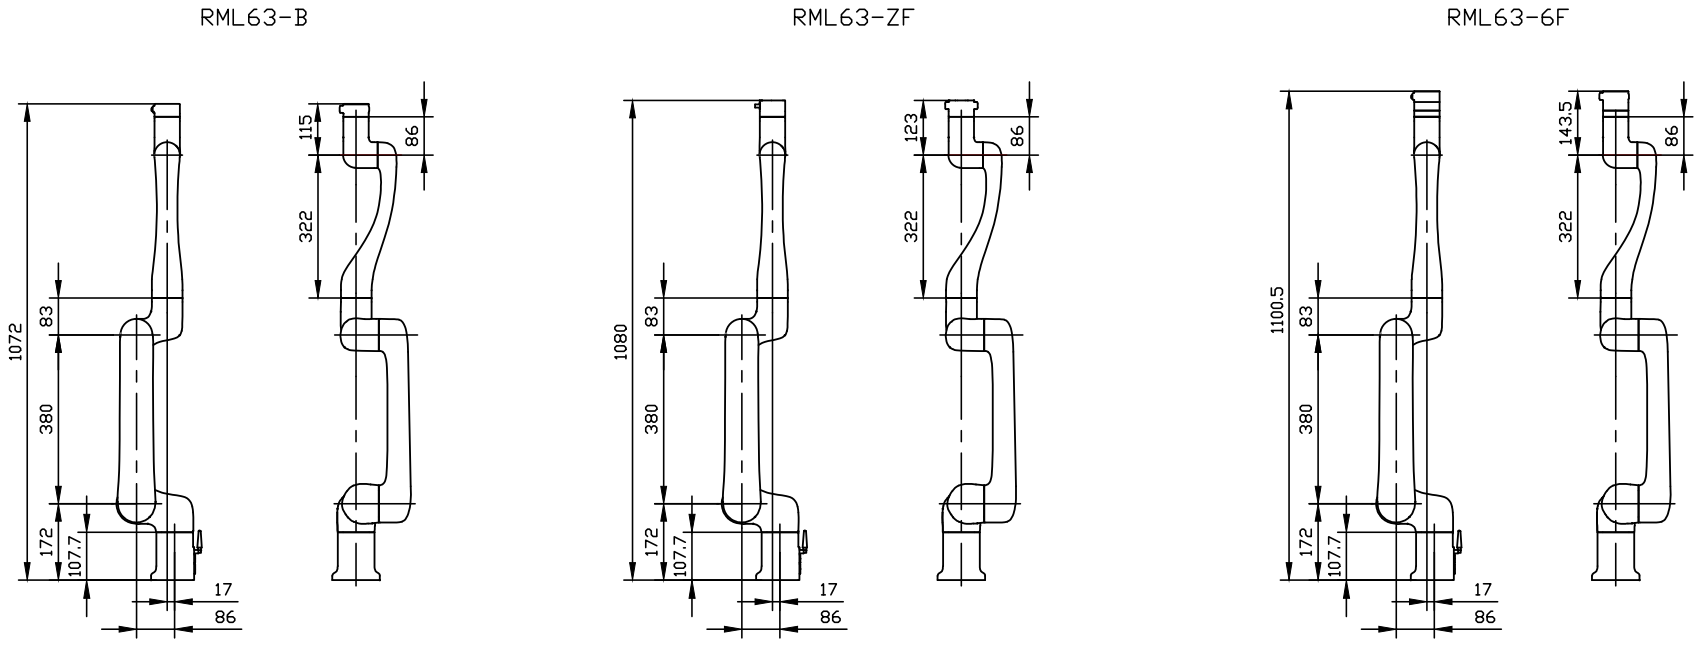
[picture p35: page 1]
