RealManRobot/rm_models/RX75/dimension/RX75_Base_Mounting_Hole_Position_Diagram.pdf

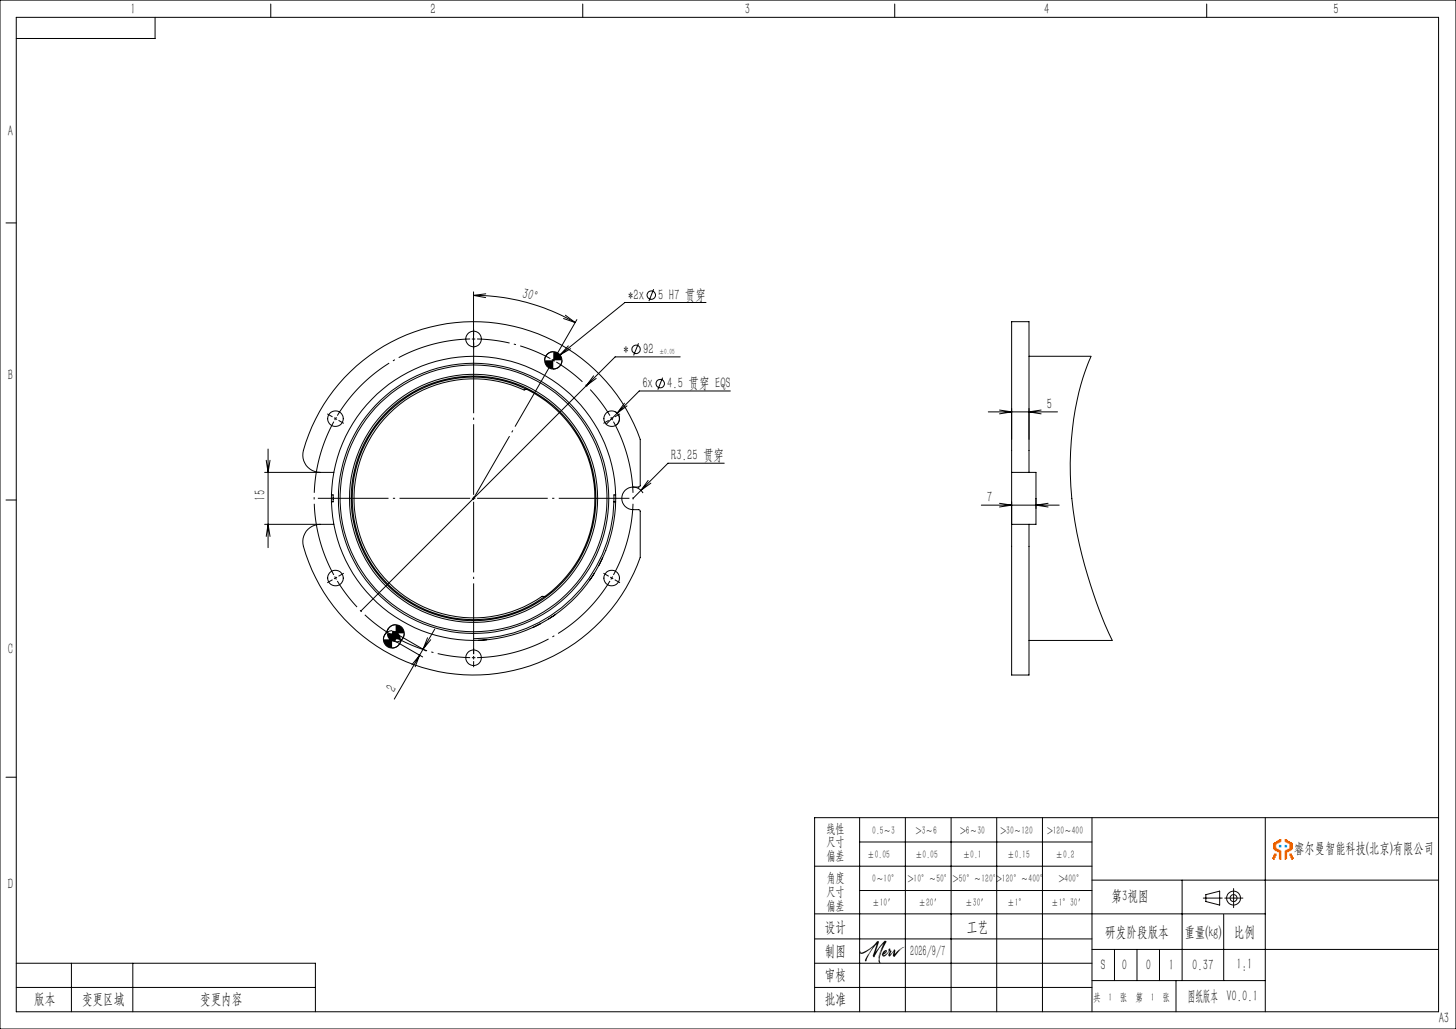
[picture p36: page 1]
6x 4.5 贯穿 EQS; 变更区域; 变更内容; 图纸版本 V0.0.1

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

设计 | | | 工艺 | | | 研发阶段版本 | 重量(kg) | 比例
制图 | | 2026/9/7
审核
