RealManRobot/rm_models/ECO63/dimension/ECO63_End_Adapter_Hole_Position_Diagram.pdf

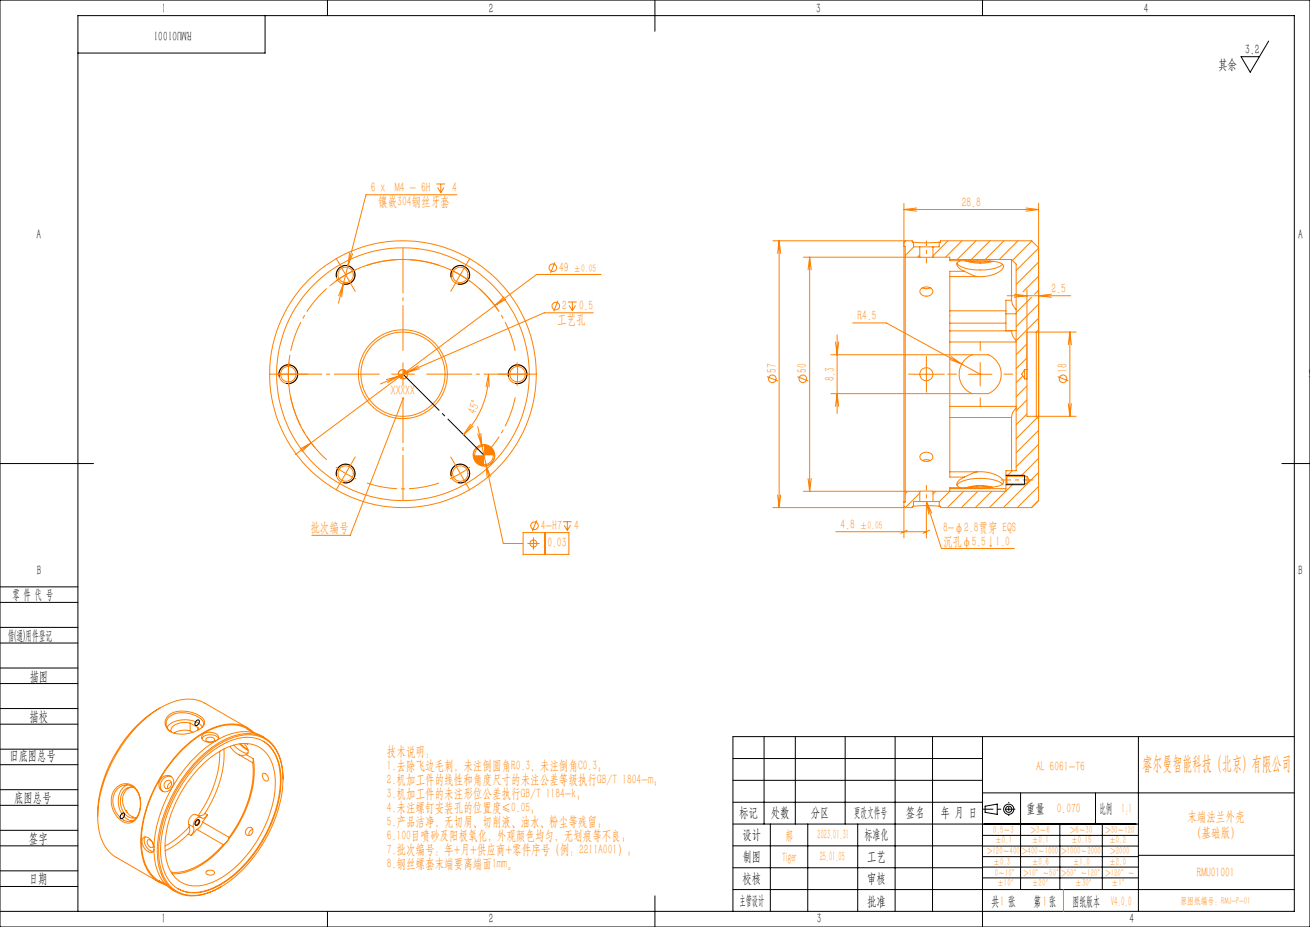
[picture p37: page 1]
8-φ2.8贯穿 EQS

技术说明：
1.去除飞边毛刺，未注倒圆角R0.3，未注倒角C0.3；
2.机加工件的线性和角度尺寸的未注公差等级执行GB/T 1804-m；
3.机加工件的未注形位公差执行GB/T 1184-k；
4.未注螺钉安装孔的位置度≤0.05；
5.产品洁净，无切屑、切削液、油水、粉尘等残留；
6.100目喷砂及阳极氧化，外观颜色均匀，无划痕等不良；
7.批次编号：年+月+供应商+零件序号（例：2211A001）;
8.钢丝螺套末端要离端面1mm。

AL 6061-T6 | 睿尔曼智能科技（北京）有限公司

标记 | 处数 | 分区 | 更改文件号 | 签名 | 年 月 日
设计 | 郝 | 2023.01.31 | 标准化 | | | 0.5～3 >3～6 >6～30 >30～120 ±0.1 ±0.1 ±0.15 ±0.2 >120～400 >400～1000 >1000～2000 >2000 ±0.3 ±0.6 ±1.0 ±2.0 0～10° >10°～50°>50°～120°>120°～ ±10′ ±20′ ±30′ ±1°
制图 | Tiger | 25.01.05 | 工艺
校核 | | | 审核

（基础版） RMU01001

主管设计 | | | 批准 | | | 共 张 1 第 张 1 | 图纸版本 V4.0.0 | 原图纸编号：RMJ-P-01
