RealManRobot/rm_models/ECO62/dimension/ECO2_End_Adapter_Hole_Position_Diagram.pdf

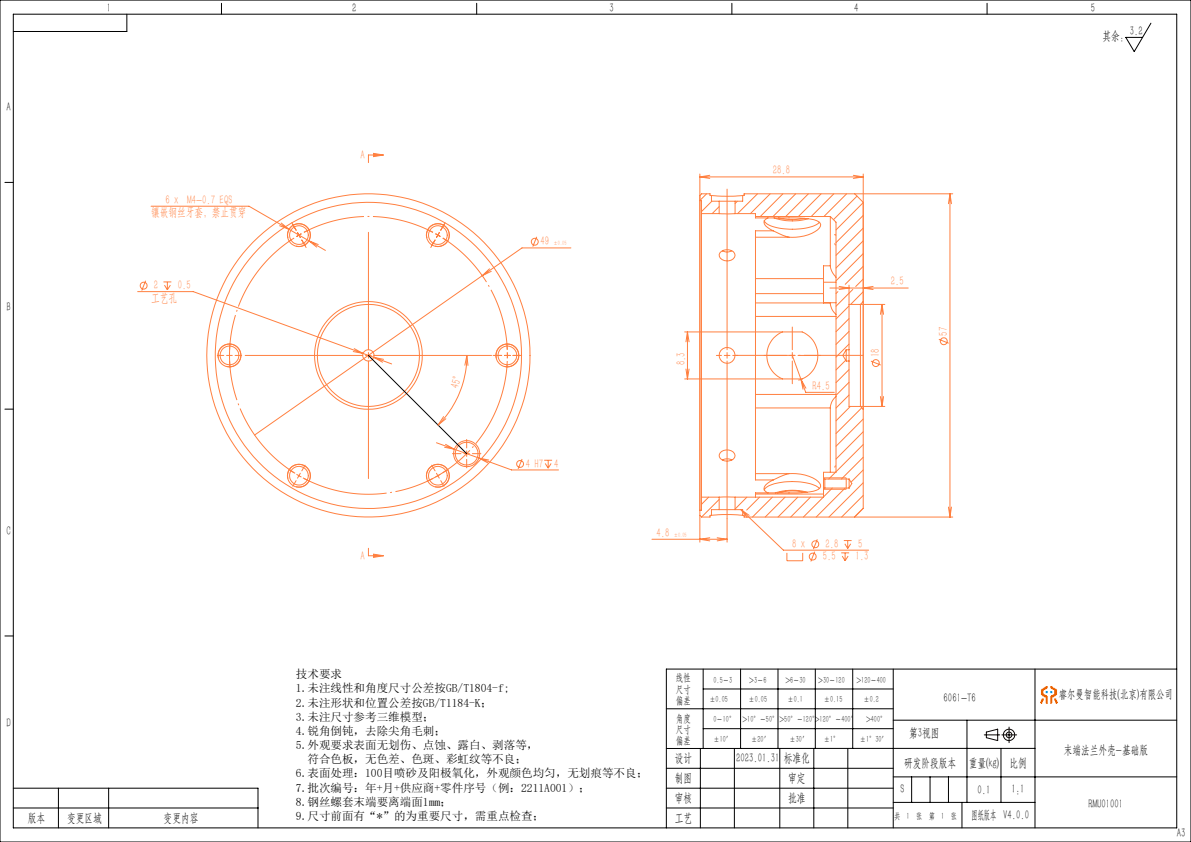
[picture p38: page 1]
6 x M4-0.7 EQS; 变更区域; 变更内容; 图纸版本 V4.0.0

技术要求
1.未注线性和角度尺寸公差按GB/T1804-f;
2.未注形状和位置公差按GB/T1184-K；
3.未注尺寸参考三维模型；
4.锐角倒钝，去除尖角毛刺；
5.外观要求表面无划伤、点蚀、露白、剥落等，
符合色板，无色差、色斑、彩虹纹等不良；
6.表面处理：100目喷砂及阳极氧化，外观颜色均匀，无划痕等不良；
7.批次编号：年+月+供应商+零件序号（例：2211A001）；
8.钢丝螺套末端要离端面1mm；
9.尺寸前面有“*”的为重要尺寸，需重点检查；

线性 尺寸 偏差 | 0.5～3 | >3～6 | >6～30 | >30～120 | >120～400 | 6061-T6 | 睿尔曼智能科技(北京)有限公司

2023.01.31 | 标准化 | | | 研发阶段版本 | 重量(kg) | 比例 | 末端法兰外壳-基础版 设计

制图 | | | 审定
批准 | | | RMU01001 审核
