RealManRobot/rm_models/ECO62/dimension/ECO62_Base_Mounting_Hole_Position_Diagram.pdf

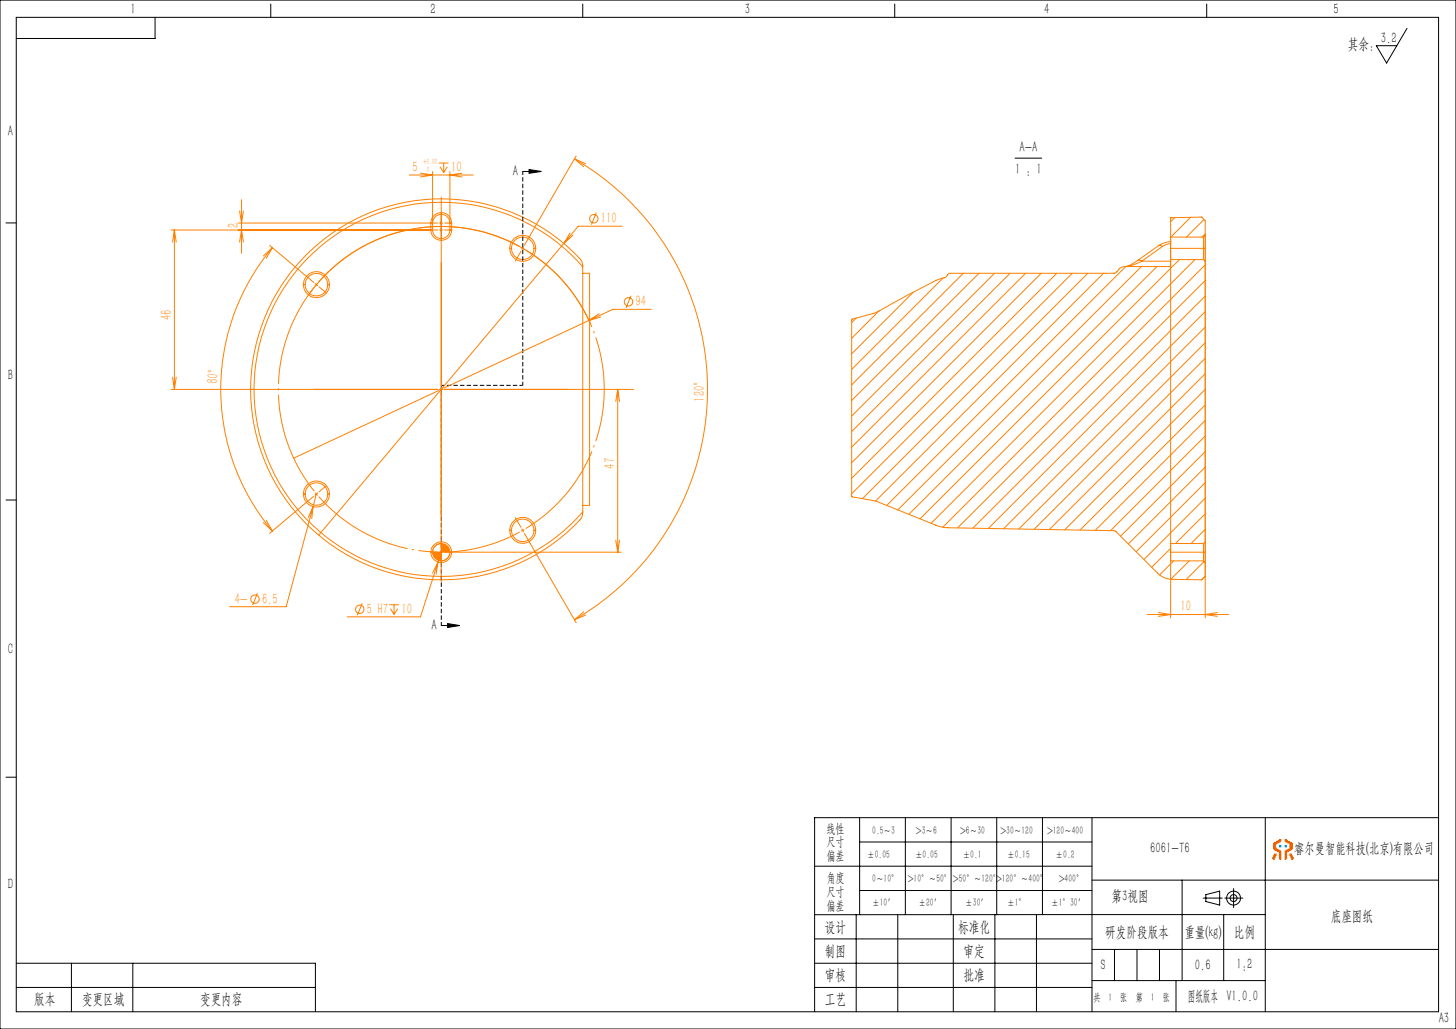
[picture p39: page 1]
标准化; 研发阶段版本 重量(kg) 比例; 底座图纸 设计; 变更区域; 变更内容; 图纸版本 V1.0.0

睿尔曼智能科技(北京)有限公司
