RealManRobot/rm_models/ECO63/dimension/ECO63_Base_Mounting_Hole_Position_Diagram.PDF

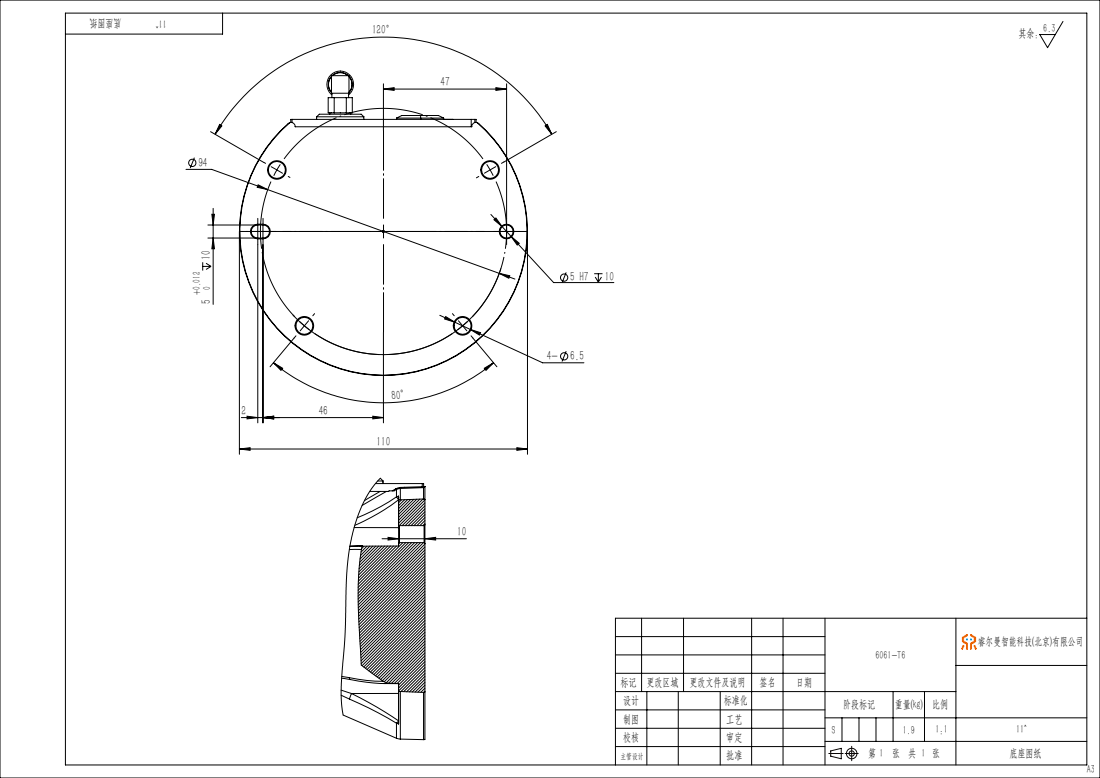
[picture p40: page 1]

睿尔曼智能科技(北京)有限公司

标记 | 更改区域 | 更改文件及说明 | 签名 | 日期
设计 | | | 标准化 | | 阶段标记 | 重量(kg) | 比例
制图 | | | 工艺
S | 1.9 | 1:1 | 11^ 校核

主管设计 | | | 批准

第 张 共 1 张 1 | | | 底座图纸
