RealManRobot/rm_models/(commit log)

2024-08-14 chore:first commit
    [GEN72.csv, GEN72.urdf, Link1.STL, Link2.STL, Link3.STL, Link4.STL, Link5.STL, Link6.STL]
2024-08-14 feat:add thirdparty urdf
2024-08-15 feat：add gen72-b model
2024-08-15 doc:1.修改stl和urdf文件设置为零位状态2.修改机械臂的限位3.修改eco656F的包名
    [GEN72.urdf, Link1.STL, Link2.STL, Link3.STL, Link4.STL, Link5.STL, Link6.STL, base_link.STL]
2024-10-10 doc:update GEN72 urdf
    [GEN72.urdf, Link7.STL]
2025-02-14 添加EC63尺寸和模型
    添加EC63尺寸和模型
    [ECO63-6FB-URDF.csv, ECO63-6FB-URDF.urdf, ECO63-B-URDF.csv, ECO63-B-URDF.urdf, Link1.STL, Link2.STL, Link3.STL, Link4.STL]
2025-02-14 更新STEP文件名称
    更新STEP文件名称
2025-03-10 新增ECO63-6FB
2025-03-10 新增一体化六维力蓝点
    [0000-eco65_URDF(2).csv, 0000-eco65_URDF(2).urdf, ECO63-6FB-URDF.csv, ECO63-6FB-URDF.urdf, Link1.STL, Link2.STL, Link3.STL, Link4.STL]
2025-03-28 更新模型尺寸
    [ECO63-6FA.csv, ECO63-6FA.urdf, ECO63-6FB-URDF.csv, ECO63-6FB-URDF.urdf, ECO63-B-URDF.csv, ECO63-B-URDF.urdf, Link1.STL, Link2.STL]
2025-03-28 新增ECO63-6F
2025-03-28 RML63模型尺寸补充
    [Link_1.STL, Link_2.STL, Link_3.STL, Link_4.STL, Link_5.STL, Link_6.STL, RML-63-B.csv, RML-63-B.urdf]
2025-12-05 更新ECO62、ECO63、ECO65、RM65、RM75、RML63II、RML63III的URDF文件
    [0000-eco65_URDF(2).csv, 0000-eco65_URDF(2).urdf, ECO63-6F.csv, ECO63-6F.urdf, ECO63-6FA.csv, ECO63-6FA.urdf, ECO63-6FB-URDF.csv, ECO63-6FB-URDF.urdf]
2026-03-18 Add robot arm type: ECO-62
    [ECO62URDF.csv, ECO62URDF.urdf, base_link.STL, link_1.STL, link_2.STL, link_3.STL, link_4.STL, link_5.STL]
2026-03-25 Add robot arm type: RX75
    [Link1.STL, Link2.STL, Link2L.STL, Link3.STL, Link4.STL, Link5.STL, Link6.STL, Link7.STL]
2026-05-18 docs: Update end adapter hole position diagram files
2026-05-26 docs: update the urdf files of RX75 and ECO62
    [ECO62URDF.urdf, Link1.STL, Link2.STL, Link2L.STL, Link3.STL, Link4.STL, Link5.STL, Link6.STL]
2026-07-03 docs: update the urdf files of RX75
    [Link1.STL, Link2.STL, Link3.STL, Link4.STL, Link5.STL, Link6.STL, Link7.STL, Link8.STL]
2026-09-29 fix: Fix abnormal link inertia parameters in the URDF file of RX75
2026-09-29 fix: Revise the base mounting drawing of RX75
2026-10-15 doc: Upload third‑party end‑effector tool structure file
2026-10-15 doc: Update third‑party end‑effector tool filenames to English
